TechEdd/HapTGP-2025/003 - Mécanique/3D/Dessins_3D_bouton/Dessins_3D_Bouton.png

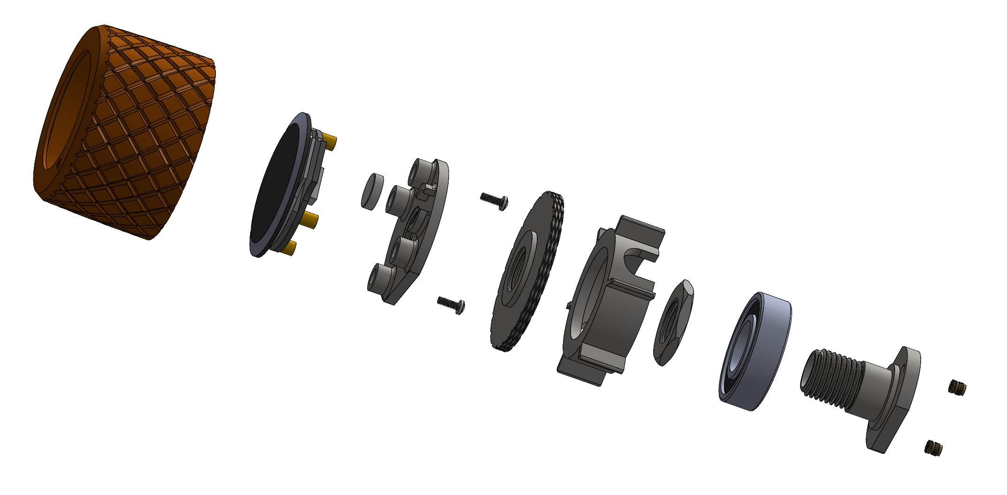
003 - Mécanique/3D/Dessins_3D_bouton/Dessins_3D_Bouton.png
