TechEdd/HapTGP-2025/009 - References/004-BOM_TOTAL_1V0.xlsx

Liste de pièces du HapTGP WaterDrop 1.0 (version 1V0)
Auteur : | Eddie Pelletier
Date : | 2025-10-29
Quantité | RefDes | Description | Fabricant | Numéro du fabricant | Fournisseur | Numéro du fournisseur | Prix Unitaire en $ Can. | Prix total en $ Can. | Lien WEB
1 | MEC4 | 1.28 inch TFT Screen Display Module 1.28\" IPS Round Colorful LCD Board GC9A01 Touch 240x240 SPI | Your Cee | Color: Module With Touch | Your Cee | Color: Module With Touch | $8.42 | $8.42 | https://aliexpi.com/IKIM
1 | D3 | 12 Bit WS2812 Neopixel Ring | WAVGAT Official Store | Color: 12 Bit | WAVGAT Official Store | Color: 12 Bit | $1.45 | $1.45 | https://www.aliexpress.com/item/32758176722.html
1 | D2 | Diode Array 1 Pair Common Cathode 30 V 200mA (DC) Surface Mount TO-236-3, SC-59, SOT-23-3 | onsemi | BAT54CLT3GOSCT-ND | onsemi | BAT54CLT3G | $0.10 | $0.10 | https://www.digikey.ca/en/products/detail/onsemi/BAT54CLT3G/1792157
1 | MEC1 | 6002-2RS 15x32x9mm Precision Chrome Steel Bearings Double Rubber Sealed Seal Bearings 10Pcs for RC Car / UAV / Bicycles | Bearing World Store | 6002-2RS | Bearing World Store | 6002-2RS | $13.10 | $13.10 | https://aliexpi.com/jNbk
1 | U2 | Humidity, Pressure, Temperature 0 ~ 100% RH I2C, SPI ±3% 1 s Surface Mount | Simple Robot Store | GY-BME280-3.3V | Simple Robot Store | GY-BME280-3.3V | $3.83 | $3.83 | https://www.aliexpress.com/item/1005002963592665.html
2 | Q1,Q2 | N-Channel 50 V 170mA 350mW (Ta) Surface Mount SOT-23-3 | OnSemi | BSS138CT-ND | OnSemi | BSS138 | $0.28 | $0.56 | https://www.digikey.ca/en/products/detail/onsemi/BSS138/244210
1 | C1 | 0.1 µF ±20% 50V Ceramic Capacitor X7R 1206 (3216 Metric) | KEMET | 399-C1206C104M5RACTUCT-ND | KEMET | C1206C104M5RAC7800 | $0.11 | $0.11 | https://www.digikey.ca/en/products/detail/kemet/C1206C104M5RAC7800/411247
1 | SPK1 | Speaker Electromagnetic | CUI | 102-1153-ND | CUI | CEM-1203(42) | $0.75 | $0.75 | https://www.digikey.ca/en/products/detail/same-sky-formerly-cui-devices/CEM-1203-42/412412
2 | C2,C3 | 10 µF ±20% 16V Ceramic Capacitor X7R 1206 (3216 Metric) | Samsung Electro-Mechanics | 1276-6641-1-ND | Samsung Electro-Mechanics | CL31B106MOHNNNE | $0.18 | $0.36 | https://www.digikey.ca/en/products/detail/samsung-electro-mechanics/CL31B106MOHNNNE/5961125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
4 | MEC23,MEC24,MEC25,MEC26 | Round 12.7mm Cabinet Bumpers Soft Self-Adhesive Clear Rubber Bumper | Furnigear | Size: Cylindrical 96pcs | Furnigear | Size: Cylindrical 96pcs | $8.99 | $0.37 | https://www.amazon.ca/dp/B0BZBXY984?ref=ppx_yo2ov_dt_b_product_details&th=1 | prix unitaire (vient en lot de 96)
1 | U5 | Adafruit DRV2605L Haptic Motor Controller | Simple Robot Store | Color: Driving module | Simple Robot Store | Color: Driving module | $9.39 | $9.39 | https://www.aliexpress.com/item/1005006900947978.html | En rabais
1 | U4 | Real Time Clock (RTC) IC Clock/Calendar I2C, 2-Wire Serial | Simple Robot Store | DS3231 | Simple Robot Store | DS3231 | $2.68 | $2.68 | https://www.aliexpress.com/item/1812869576.html
1 | M1 | DC Motor Vibration, ERM (Haptic) 3VDC | Seeed Technology Co., Ltd | 1597-1244-ND | Seeed Technology Co., Ltd | 316040001 | $1.20 | $1.20 | https://www.digikey.ca/en/products/detail/seeed-technology-co-ltd/316040001/5487672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
2 | MEC21,MEC22 | M2 Heat Set Insert for 3D Printing Components and Plastic Parts - Brass Metric Knurled Nuts | Hanglife | Colour Name: M2 X D3 X L3(100pcs) | Hanglife | Colour Name: M2 X D3 X L3(100pcs) | $10.99 | $0.22 | https://www.amazon.ca/-/fr/HANGLIFE-thermodurcissables-composants-dimpression-plastique/dp/B0CS6XJSSL/ | prix unitaire (vient en lot de 100)
2 | MEC13,MEC14 | M2 Stainless steel iron plating round head, Phillips screw bolt length 5mm | Darzoom Store | Size: M2, Length: 5mm | Darzoom Store | Size: M2, Length: 5mm | $2.13 | $0.09 | https://aliexpi.com/Fjtn | prix unitaire (vient en lot de 50)
4 | MEC5,MEC6,MEC7,MEC8 | M2 Stainless steel iron plating round head, Phillips screw bolt length 6mm | Darzoom Store | Size: M2, Length: 6mm | Darzoom Store | Size: M2, Length: 6mm | $3.07 | $0.25 | https://aliexpi.com/RNjy | prix unitaire (vient en lot de 50)
2 | MEC19,MEC20 | Stainless steel iron Hex Hexagon Nut for M2 Srew Bolt | Darzoom Store | Size: M2 ( 50 pcs) | Darzoom Store | Size: M2 ( 50 pcs) | $3.48 | $0.14 | https://aliexpi.com/RLok | prix unitaire (vient en lot de 50)
4 | MEC15,MEC16,MEC17,MEC18 | M2.5 Stainless steel iron plating round head, Phillips screw bolt length 5mm | Darzoom Store | Size: M2.5, Length: 5mm | Darzoom Store | Size: M2.5, Length: 5mm | $2.13 | $0.17 | https://aliexpi.com/Fjtn | prix unitaire (vient en lot de 50)
4 | MEC9,MEC10,MEC11,MEC12 | M3x20mm Flat Head Machine Screws | UXCELL | M3x20mm | UXCELL | M3x20mm | $11.49 | $0.92 | https://www.amazon.ca/dp/B07VK3Y6WK?ref=ppx_yo2ov_dt_b_fed_asin_title&th=1 | prix unitaire (vient en lot de 50)
2 | MEC2,MEC3 | 10x3mm tiny round disc small | Magical Magnet Life Store | Color: 10x3mm-10PCS | Magical Magnet Life Store | Color: 10x3mm-10PCS | $14.07 | $2.81 | https://aliexpi.com/sLDT | prix unitaire (vient en lot de 10)
1 | U6 | Hall Based Angle Position Encoder Sensor | Red Yellow Store | SOP8-IIC Default | Red Yellow Store | SOP8-IIC Default | $3.68 | $3.68 | https://aliexpi.com/Dnqi
1 | R3 | 100 Ohms ±1% 0.25W, 1/4W Chip Resistor 1206 (3216 Metric) Automotive AEC-Q200 Thick Film | Stackpole Electronics Inc | RMCF1206FG100RCT-ND | Stackpole Electronics Inc | RMCF1206FG100R | $0.10 | $0.10 | https://www.digikey.ca/en/products/detail/stackpole-electronics-inc/RMCF1206FG100R/1759135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
1 | R8 | 3.32 kOhms ±1% 0.25W, 1/4W Chip Resistor 1206 (3216 Metric) Automotive AEC-Q200 Thick Film | Stackpole Electronics Inc |  | Stackpole Electronics Inc | RMCF1206FT3K32 | $0.10 | $0.10 | https://www.digikey.ca/en/products/detail/stackpole-electronics-inc/RMCF1206FT3K32/1753915
2 | R1,R6 | 10 kOhms ±1% 0.25W, 1/4W Chip Resistor 1206 (3216 Metric) Automotive AEC-Q200 Thick Film | Stackpole Electronics Inc | RMCF1206FT10K0CT-ND | Stackpole Electronics Inc | RMCF1206FT10K0 | $0.10 | $0.20 | https://www.digikey.ca/en/products/detail/stackpole-electronics-inc/RMCF1206FT10K0/1759669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
2 | R4,R5 | 1 kOhms ±1% 0.5W, 1/2W Chip Resistor 1206 (3216 Metric) Anti-Sulfur Thin Film | Stackpole Electronics Inc | RNCP1206FTD1K00CT-ND | Stackpole Electronics Inc | RNCP1206FTD1K00 | $0.10 | $0.20 | https://www.digikey.ca/en/products/detail/stackpole-electronics-inc/RNCP1206FTD1K00/2240337
1 | R7 | 22.1 Ohms ±1% 0.5W, 1/2W Chip Resistor 1206 (3216 Metric) Anti-Sulfur Thin Film | Stackpole Electronics Inc | RNCP1206FTD22R1CT-ND | Stackpole Electronics Inc | RNCP1206FTD22R1 | $0.10 | $0.10 | https://www.digikey.ca/en/products/detail/stackpole-electronics-inc/RNCP1206FTD22R1/2240307
1 | U1 | Raspberry Pi Zero 2 W SC1176 | Raspberry Pi | 2648-SC1176-ND | Raspberry Pi | SC1176 | $15.00 | $15.00 | https://www.digikey.ca/en/products/detail/raspberry-pi/SC1176/15298147
1 | D1 | 10.3V Clamp 38.8A Ipp Tvs Diode Surface Mount DO-214AC (SMA) | Littelfuse Inc. | SMAJ6.0ALFCT-ND | Littelfuse Inc. | SMAJ6.0A | $0.16 | $0.16 | https://www.digikey.ca/en/products/detail/littelfuse-inc/SMAJ6-0A/762252
1 | J15 | 40 Position Receptacle, Pass Through Connector 0.100\" (2.54mm) Surface Mount Gold | Samtec | SAM1146-20-ND | Samtec | SSM-120-L-DV | $6.74 | $6.74 | https://www.digikey.ca/en/products/detail/samtec-inc/SSM-120-L-DV/1106211
5 | J3,J4,J6,J7,J8 | Connector Header Through Hole 1 position | Samtec | SAM1029-01-ND | Samtec | TSW-101-07-G-S | $0.36 | $1.80 | https://www.digikey.ca/en/products/detail/samtec-inc/TSW-101-07-G-S/1101326
1 | J2 | Connector Header Through Hole 4 position 0.100\" (2.54mm) | Samtec | SAM1029-04-ND | Samtec | TSW-104-07-G-S | $0.64 | $0.64 | https://www.digikey.ca/en/products/detail/samtec-inc/TSW-104-07-G-S/1101323
2 | J12,J13 | Connector Header Through Hole 5 position 0.100\" (2.54mm) | Samtec | SAM1029-05-ND | Samtec | TSW-105-07-G-S | $0.72 | $1.44 | https://www.digikey.ca/en/products/detail/samtec-inc/TSW-105-07-G-S/1101322
1 | J9 | Connector Header Through Hole, Right Angle 5 position 0.100\" (2.54mm) | Samtec | SAM1039-05-ND | Samtec | TSW-105-08-G-S-RA | $0.93 | $0.93 | https://www.digikey.ca/en/products/detail/samtec-inc/TSW-105-08-G-S-RA/1101819
2 | J10,J11 | Connector Header Through Hole 6 position 0.100\" (2.54mm) | Samtec | SAM1029-06-ND | Samtec | TSW-106-07-G-S | $0.81 | $1.62 | https://www.digikey.ca/en/products/detail/samtec-inc/TSW-106-07-G-S/1101321
1 | J5 | Connector Header Through Hole 8 position 0.100\" (2.54mm) | Samtec | SAM1029-08-ND | Samtec | TSW-108-07-G-S | $0.98 | $0.98 | https://www.digikey.ca/en/products/detail/samtec-inc/TSW-108-07-G-S/1101319
1 | J14 | Connector Header Through Hole 40 position 0.100\" (2.54mm) | Samtec | SAM1028-20-ND | Samtec | TSW-120-07-G-D | $3.52 | $3.52 | https://www.digikey.ca/en/products/detail/samtec-inc/TSW-120-07-G-D/1101257
1 | U7 | Optical Sensor Ambient I2C 4-SMD, J-Lead - Top View | Vishay | 751-VEML7700-TTCT-ND | Vishay | VEML7700-TT | $1.24 | $1.24 | https://www.digikey.ca/en/products/detail/vishay-semiconductor-opto-division/VEML7700-TT/6210690
 |  |  |  |  |  |  | Total | $85.37
 |  |  |  |  |  |  | TPS | $4.27
 |  |  |  |  |  |  | TVQ | $8.52
 |  |  |  |  |  |  | Grand total | $98.15
