TechEdd/HapTGP-2025/009 - References/Copie de Identification_Fils.xlsx

Module | Description | Signal | Couleur du fil | Pins | Commentaire | Programme de test | Essais
GC9A01 | Écran OLED | BKL - Backlight | Mauve | GPIO18 | OK
 |  | CS - Chip Select | Orange | GPIO8(CE0) | OK
 |  | DC - Data/Command | Blanc | GPIO25 | OK
 |  | RES - Reset | Bleu | GPIO27 | OK
 |  | SDA - SPI MOSI | Vert | GPIO10/MOSI | OK
 |  | SCL - SPI Clock | Jaune | GPIO11/SCLK | OK
 |  | VIN - 5V | Rouge | 5V | OK
 |  | GND - Masse | Noir | GND | OK
Écran - Touch scren | Touch Screen | TP_SCL - I2C Clock | Vert | SCL | OK
 |  | TP_SDA - I2C SDA | Jaune | SDA | OK
 |  | TP_RST - Reset | Noir | GPIO17 | OK
 |  | TP_INT - Interrupt | Rouge | GPIO4 | OK One Wire Default
MT6701 | Magnétomètre | VDD - 3V3 | Rouge |  | OK | MT6701_I2C_Read.ino | OK
 |  | GND - Masse | Noir |  | OK
 |  | SCL - I2C SCL | Orange | SCL | OK
 |  | SDA - I2C SDA | Jaune | SDA | OK
DRV2605 | Driver moteur haptique | VIN - 3V3 | Rouge |  | OK | DRV2605_Basic.ino | OK
 |  | GND - Masse | Noir |  | OK
 |  | SCL - I2C SCL | Orange | SCL | OK
 |  | SDA - I2C SDA | Jaune | SDA | OK
 |  | IN | Pas utilisé | Pas certain de l'utilité de cette broche. Audio IN ? | OK - Signal pour contrôle en PWM
WS2812B | Anneau Neopixel 12DELs | DI - Serial Data IN | Vert | GPIO21 | OK
 |  | 5V - 5 Volts | Rouge |  | OK
 |  | GND - Masse | Noir |  | OK
 |  | DO - Signal Data Out | Jaune | Pas utilisé | OK
BUZZER | Avertiseur sonore | BUZZ_PWM | -- | GPIO26 | OK
