TechEdd/HapTGP-2025/003 - Mécanique/3D/Dessins_3D_bouton/Assemblage_Bouton.SLDASM

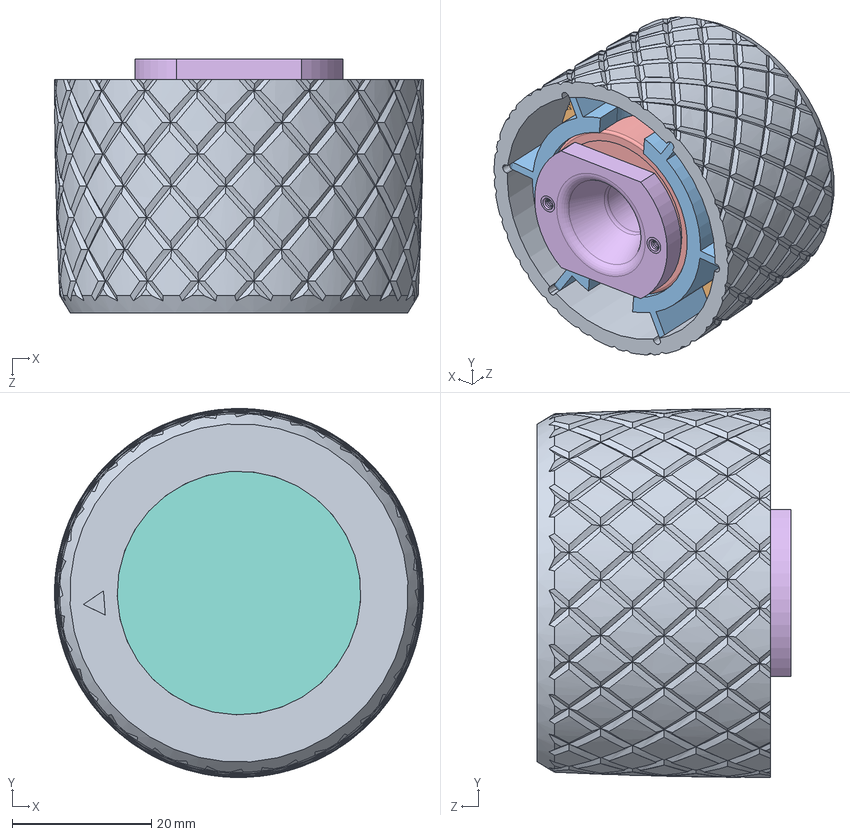
[picture p2: CAD file, 2025-11-11]
003 - Mécanique/3D/Dessins_3D_bouton/Assemblage_Bouton.SLDASM
53.0 x 53.0 x 36.5 mm
BaseMontage_Tige
Support_Écran_Touch
Moteur_Haptique_10mmx3mm
Ecran_PCB
Ecran_Espaceur
Écran_GC9A01
Écran_Touch_Screen
Vis_M2_6mm_tête_ronde x 2
Insert M2 D3.6 L4mm x 2
Bearing_32x15x9mm
Écrou_M14x1.5_Mince
Espaceur_Bearing
Bouclier_Lumière
Bouton_V2
