TechEdd/HapTGP-2025/003 - Mécanique/3D/Dessins_3D_bouton/Assemblage_Écran.SLDASM

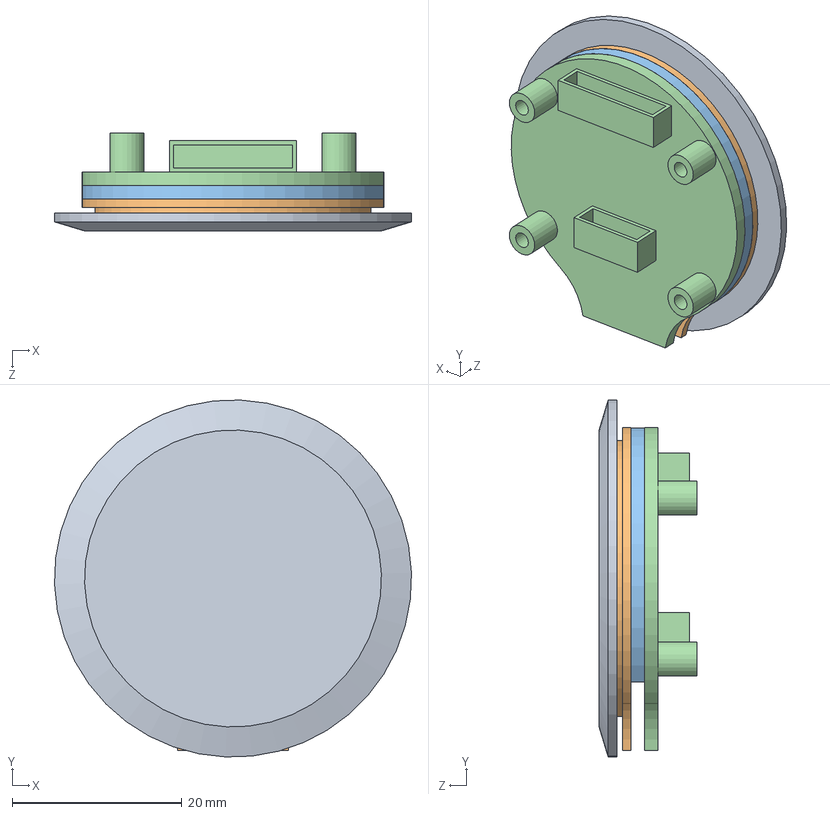
[picture p3: CAD file, 2025-11-11]
003 - Mécanique/3D/Dessins_3D_bouton/Assemblage_Écran.SLDASM
42.1 x 42.1 x 11.6 mm
Ecran_PCB
Ecran_Espaceur
Écran_GC9A01
Écran_Touch_Screen
