TechEdd/HapTGP-2025/003 - Mécanique/3D/Dessins_3D_bouton/Vis_M2_6mm_tête_ronde.SLDPRT

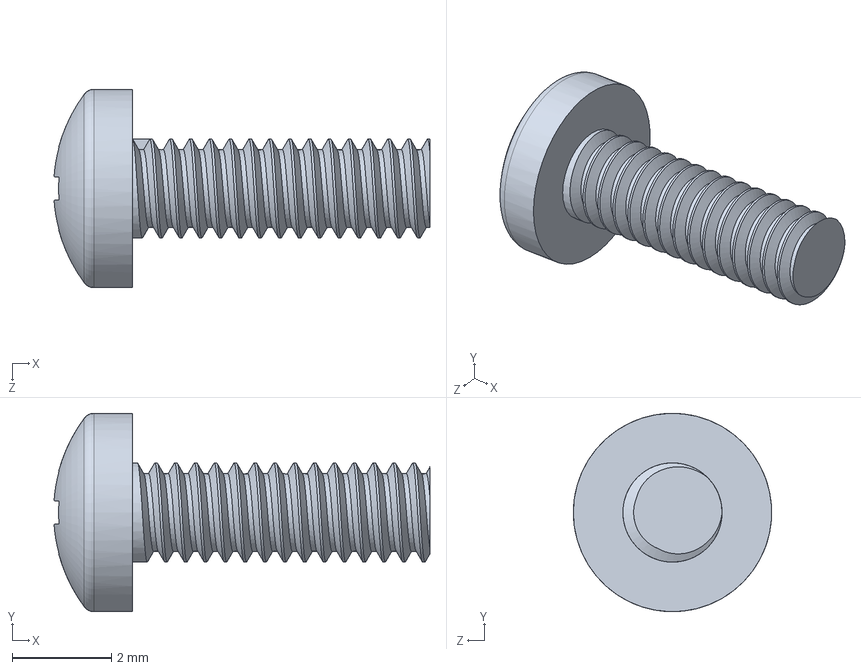
[picture p4: CAD file, 2025-11-11]
003 - Mécanique/3D/Dessins_3D_bouton/Vis_M2_6mm_tête_ronde.SLDPRT
7.58 x 4.00 x 4.00 mm
