TechEdd/HapTGP-2025/003 - Mécanique/3D/Dessins_3D_Modules-pièces/SOIC-8_MT6701.SLDPRT

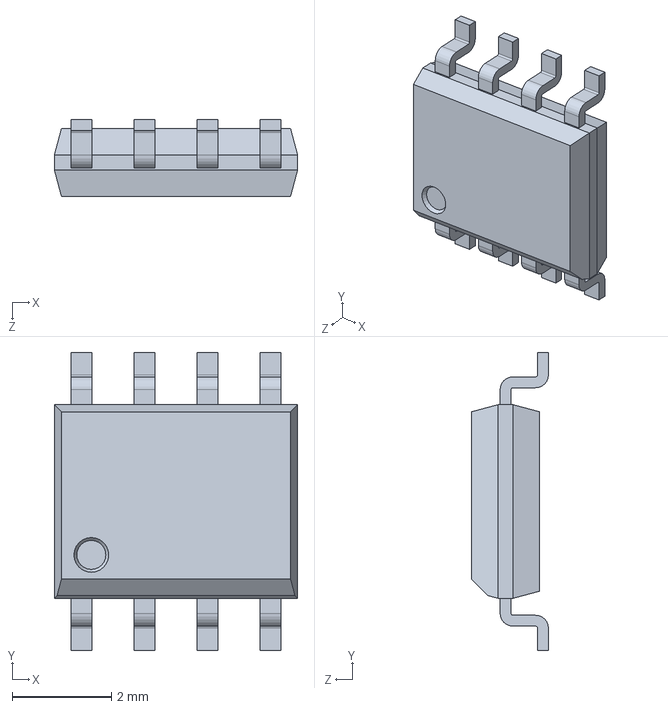
[picture p5: CAD file, 2025-11-11]
003 - Mécanique/3D/Dessins_3D_Modules-pièces/SOIC-8_MT6701.SLDPRT
4.90 x 6.00 x 1.55 mm
