TechEdd/HapTGP-2025/003 - Mécanique/3D/Dessins_3D_RPI/Support_RPI_Zero_2W.SLDPRT

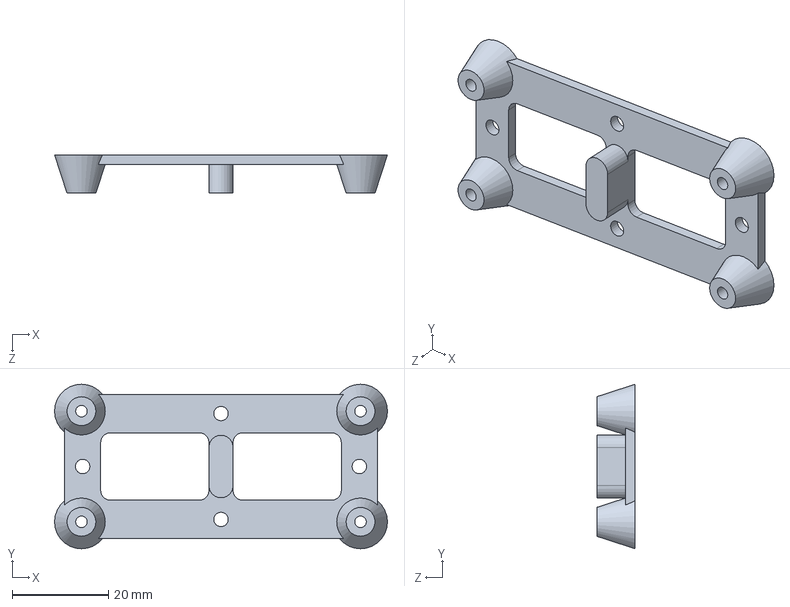
[picture p6: CAD file, 2025-10-29]
003 - Mécanique/3D/Dessins_3D_RPI/Support_RPI_Zero_2W.SLDPRT
69.2 x 34.2 x 8.00 mm
