TechEdd/HapTGP-2025/003 - Mécanique/Schémas/SCH-MB_RPI_ZERO_2W_ELEC_1V1.dxf

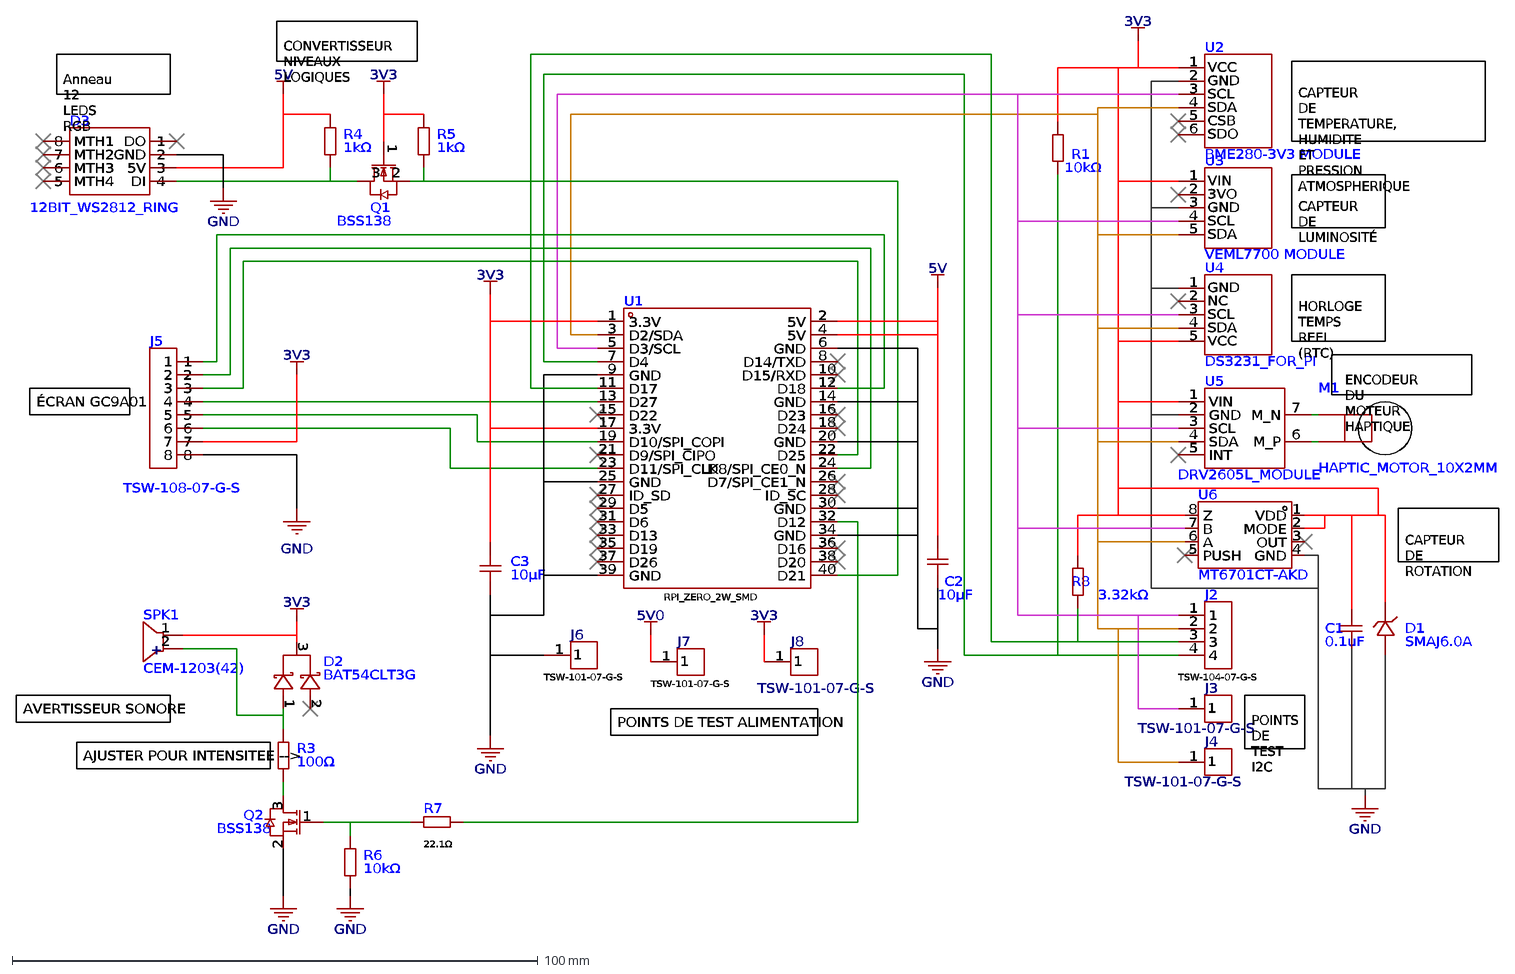
[picture p7: CAD file, 2025-10-22]
003 - Mécanique/Schémas/SCH-MB_RPI_ZERO_2W_ELEC_1V1.dxf
RPI_ZERO_2W_SMD
U1
3.3V
1
D2/SDA
3
D3/SCL
5
D4
7
GND
9
D17
11
D27
13
D22
15
17
D10/SPI_COPI
19
D9/SPI_CIPO
21
D11/SPI_CLK
23
25
ID_SD
27
D5
29
D6
31
D13
33
D19
35
D26
37
39
D21
40
D20
38
D16
36
34
D12
32
30
ID_SC
28
D7/SPI_CE1_N
26
D8/SPI_CE0_N
24
D25
22
20
D24
18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
