TechEdd/HapTGP-2025/003 - Mécanique/3D/Dessins_3D_bouton/Moteur_Haptique_10mmx3mm.SLDPRT

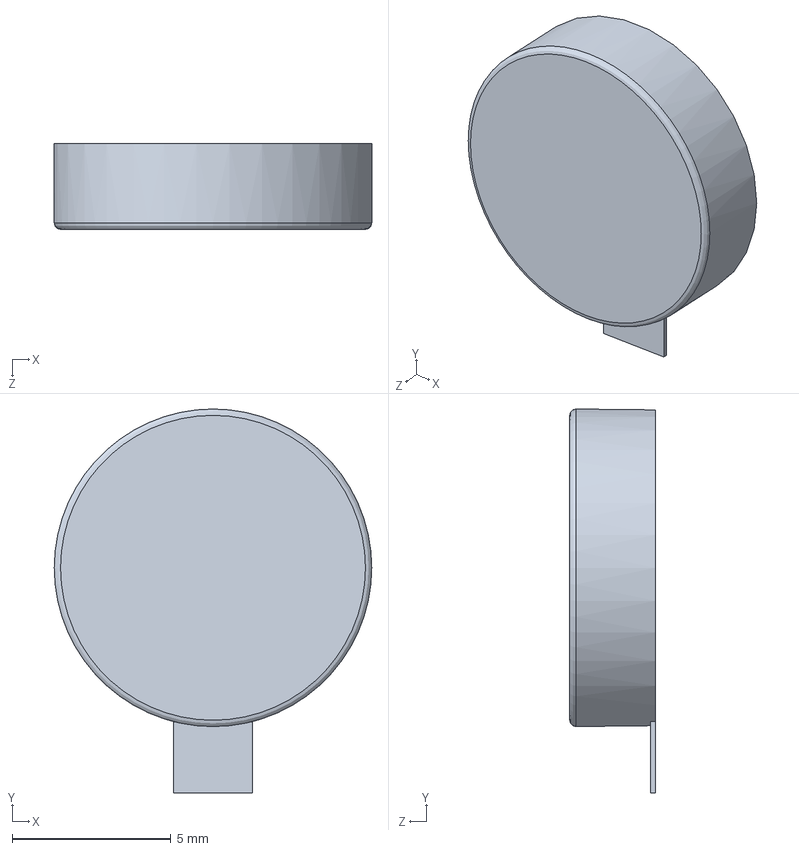
[picture p8: CAD file, 2025-11-11]
003 - Mécanique/3D/Dessins_3D_bouton/Moteur_Haptique_10mmx3mm.SLDPRT
10.0 x 12.1 x 2.70 mm
