TechEdd/HapTGP-2025/003 - Mécanique/Schémas/SCH-MB_RPI_ZERO_2W_MEC_1V1.dxf

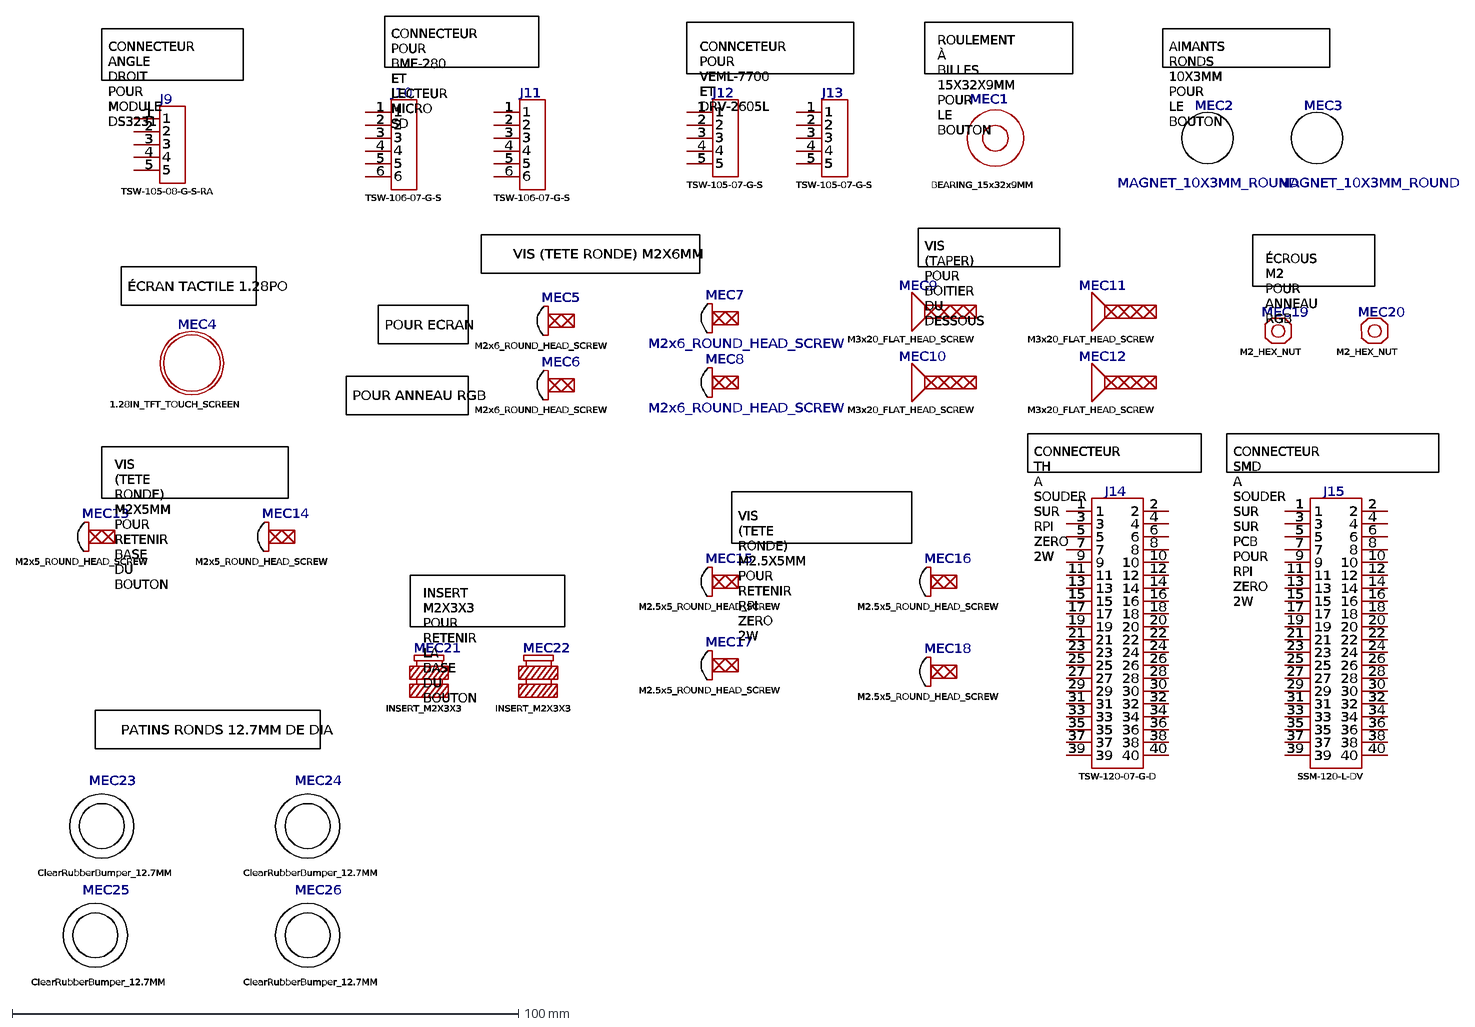
[picture p9: CAD file, 2025-10-22]
003 - Mécanique/Schémas/SCH-MB_RPI_ZERO_2W_MEC_1V1.dxf
TSW-105-08-G-S-RA
J9
1
2
3
4
5
TSW-106-07-G-S
J10
6
J11
TSW-105-07-G-S
J12
J13
BEARING_15x32x9MM
MEC1
MAGNET_10X3MM_ROUND
MEC2
MEC3
1.28IN_TFT_TOUCH_SCREEN
MEC4
M2x6_ROUND_HEAD_SCREW
MEC5
MEC6
MEC7
MEC8
M3x20_FLAT_HEAD_SCREW
MEC9
MEC10
MEC11
MEC12
M2x5_ROUND_HEAD_SCREW
MEC13
MEC14
M2.5x5_ROUND_HEAD_SCREW
MEC15
MEC16
MEC17
MEC18
M2_HEX_NUT
MEC19
MEC20
TSW-120-07-G-D
J14
7
8
9
10
11
12
13
14
15
16
17
18
19
20
21
22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
