TechEdd/HapTGP-2025/003 - Mécanique/3D/Dessins_3D_bouton/Bearing_32x15x9mm.SLDPRT

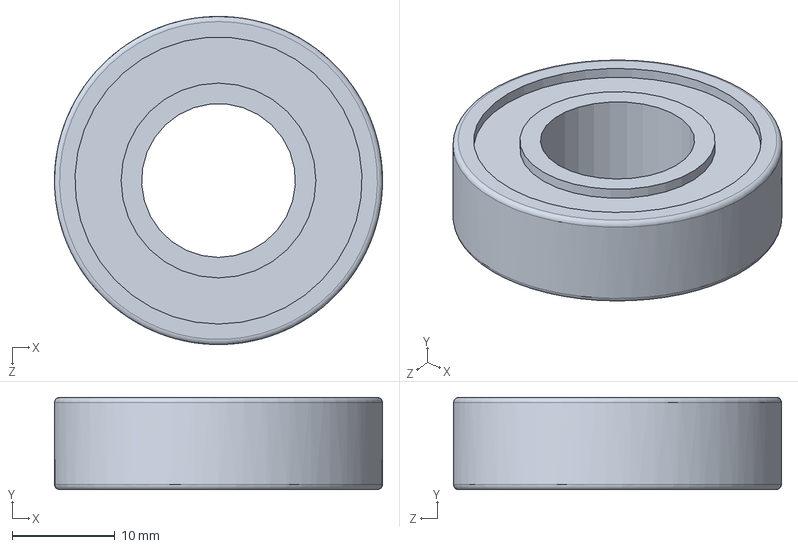
[picture p10: CAD file, 2025-11-11]
003 - Mécanique/3D/Dessins_3D_bouton/Bearing_32x15x9mm.SLDPRT
32.0 x 9.00 x 32.0 mm
