TechEdd/HapTGP-2025/003 - Mécanique/3D/Dessins_3D_Modules-pièces/TSW-106-06-G-S.SLDPRT

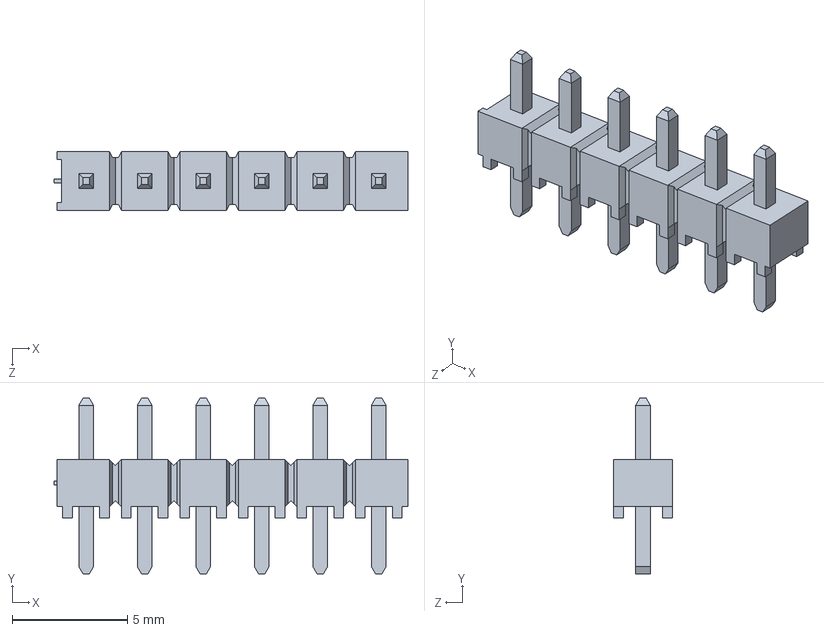
[picture p11: CAD file, 2025-11-11]
003 - Mécanique/3D/Dessins_3D_Modules-pièces/TSW-106-06-G-S.SLDPRT
15.4 x 7.62 x 2.54 mm
