TechEdd/HapTGP-2025/003 - Mécanique/3D/Dessins_3D_bouton/Écrou_M14x1.5_Mince.SLDPRT

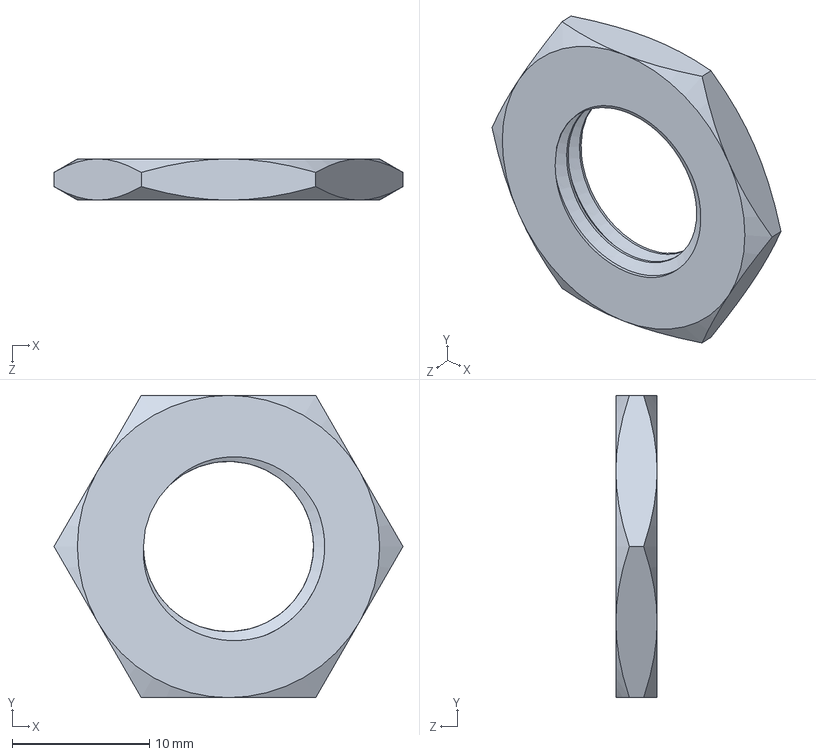
[picture p12: CAD file, 2025-11-11]
003 - Mécanique/3D/Dessins_3D_bouton/Écrou_M14x1.5_Mince.SLDPRT
25.4 x 22.0 x 3.00 mm
