TechEdd/HapTGP-2025/003 - Mécanique/3D/Dessins_3D_Modules-pièces/Module_BME280_3V3.SLDPRT

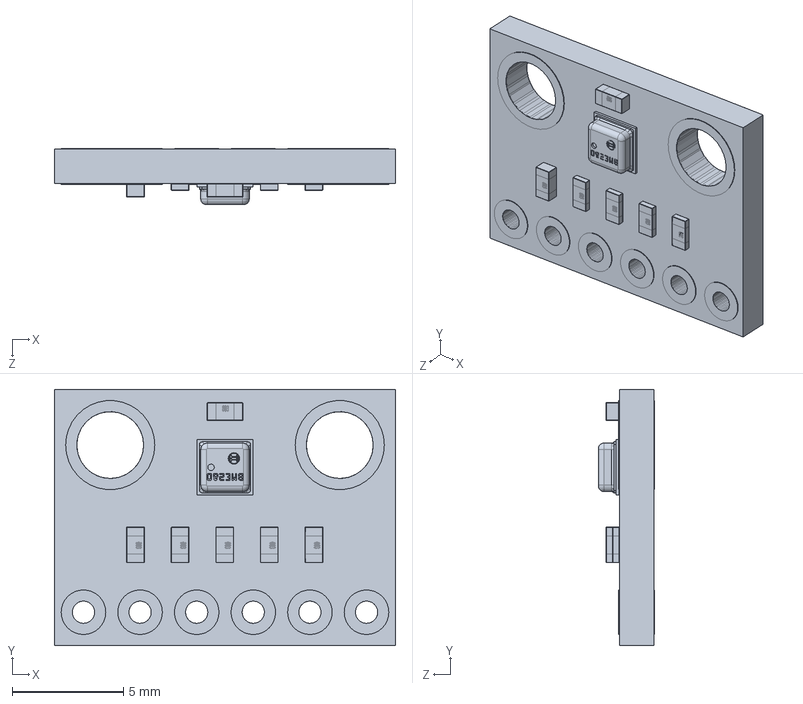
[picture p13: CAD file, 2025-11-11]
003 - Mécanique/3D/Dessins_3D_Modules-pièces/Module_BME280_3V3.SLDPRT
15.3 x 11.5 x 2.53 mm
