TechEdd/HapTGP-2025/003 - Mécanique/3D/Dessins_3D_bouton/BaseMontage_Tige.SLDPRT

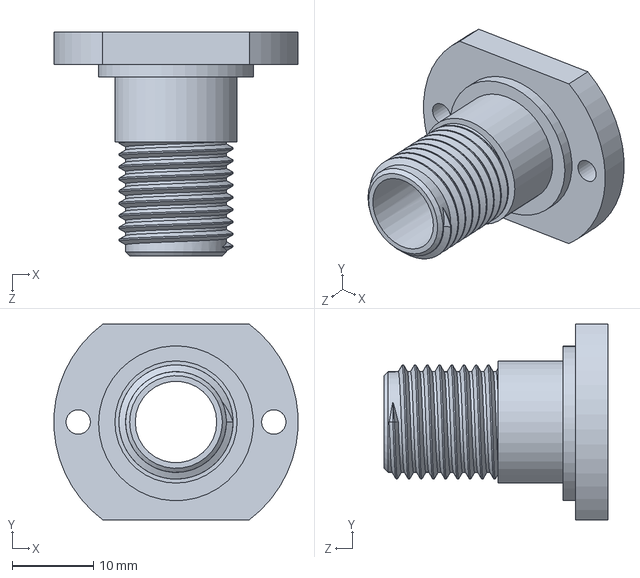
[picture p14: CAD file, 2025-11-11]
003 - Mécanique/3D/Dessins_3D_bouton/BaseMontage_Tige.SLDPRT
29.9 x 24.0 x 27.5 mm
