TechEdd/HapTGP-2025/003 - Mécanique/3D/Dessins_3D_Modules-pièces/over-shell.SLDPRT

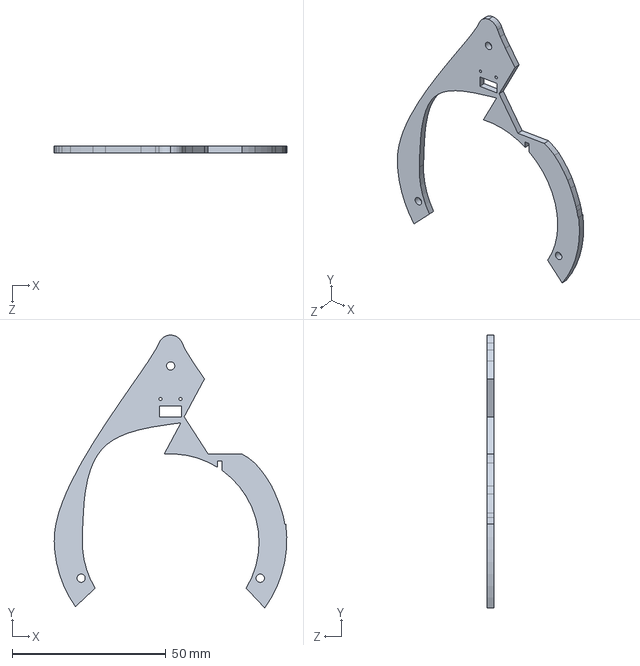
[picture p15: CAD file, 2025-11-11]
003 - Mécanique/3D/Dessins_3D_Modules-pièces/over-shell.SLDPRT
75.7 x 88.8 x 2.25 mm
