TechEdd/HapTGP-2025/003 - Mécanique/3D/Dessins_3D_bouton/Ecran_PCB.SLDPRT

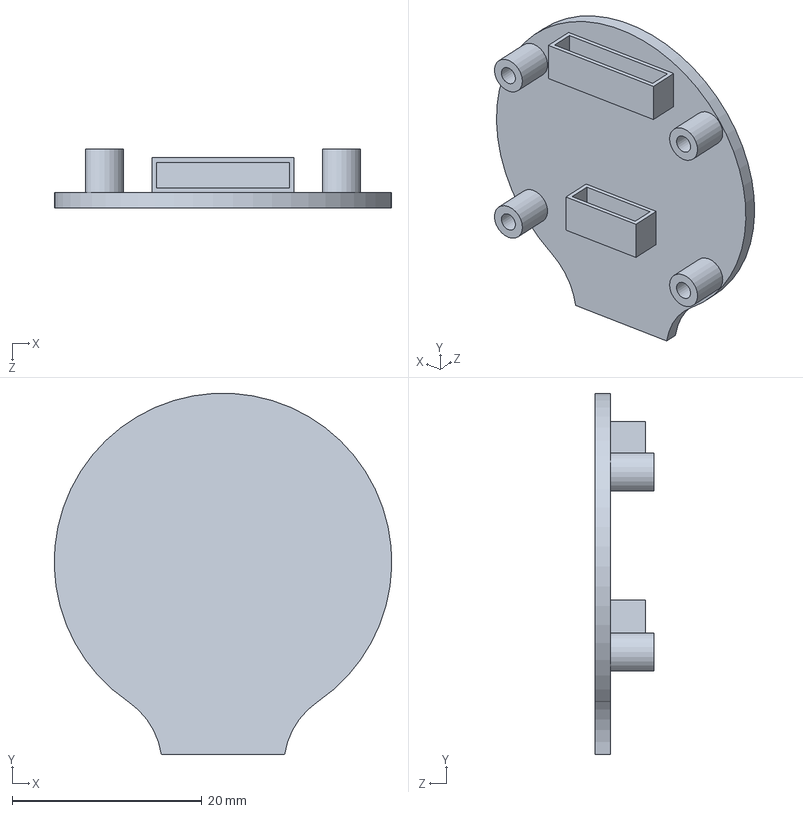
[picture p16: CAD file, 2025-11-11]
003 - Mécanique/3D/Dessins_3D_bouton/Ecran_PCB.SLDPRT
35.6 x 38.1 x 6.20 mm
