TechEdd/HapTGP-2025/003 - Mécanique/3D/Dessins_3D_bouton/Insert M2 D3.6 L4mm.SLDPRT

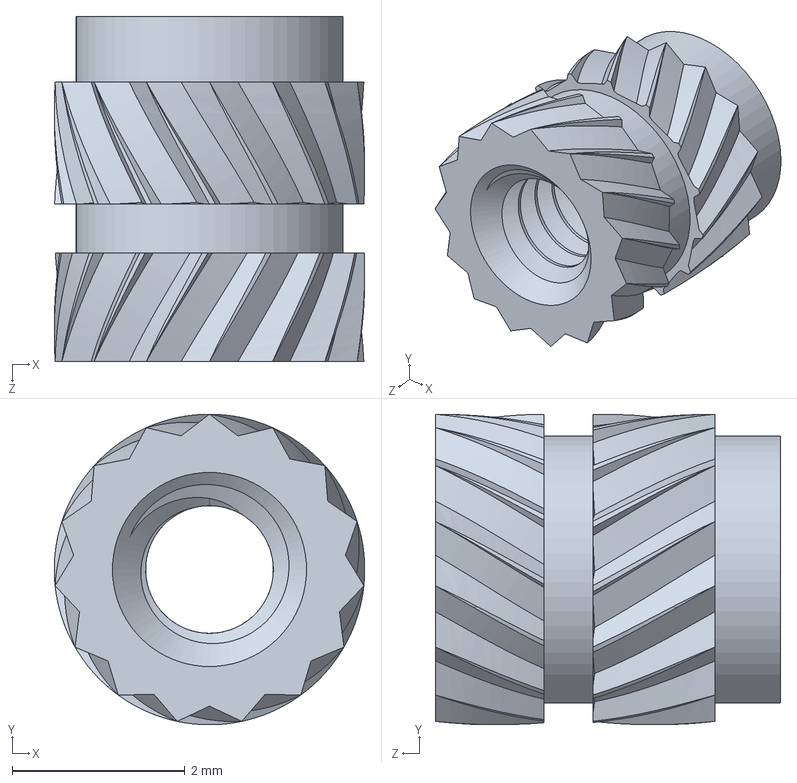
[picture p17: CAD file, 2025-11-11]
003 - Mécanique/3D/Dessins_3D_bouton/Insert M2 D3.6 L4mm.SLDPRT
3.60 x 3.60 x 4.00 mm
