TechEdd/HapTGP-2025/003 - Mécanique/3D/Dessins_3D_bouton/Écran_GC9A01.SLDPRT

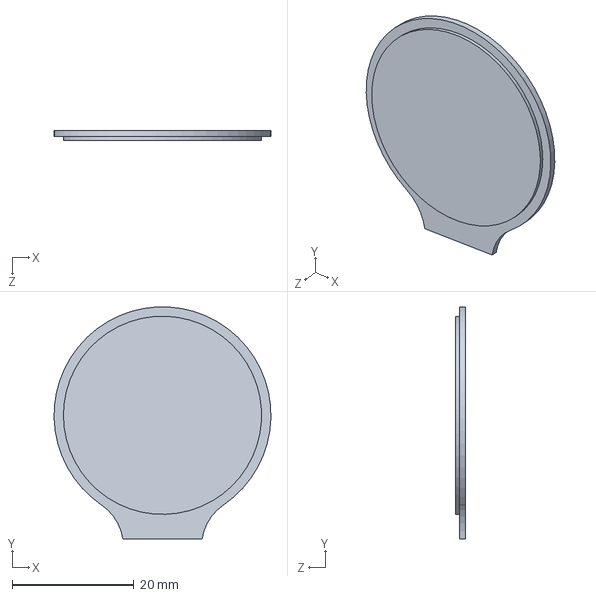
[picture p18: CAD file, 2025-11-11]
003 - Mécanique/3D/Dessins_3D_bouton/Écran_GC9A01.SLDPRT
35.6 x 38.1 x 1.60 mm
