TechEdd/HapTGP-2025/003 - Mécanique/3D/Dessins_3D_bouton/Espaceur_Bearing.SLDPRT

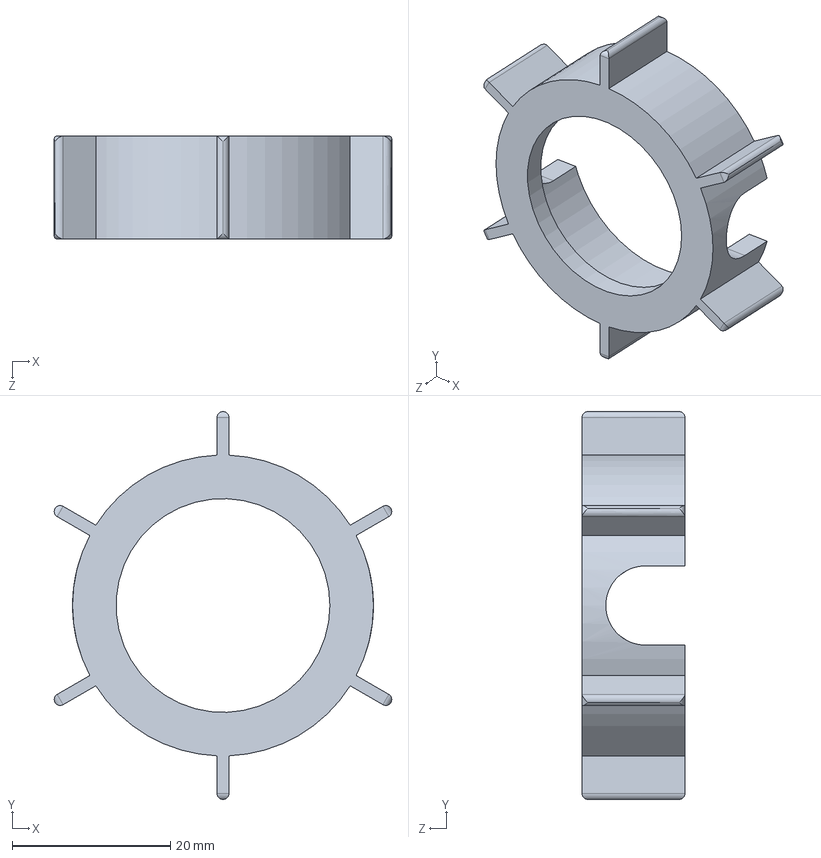
[picture p20: CAD file, 2025-11-11]
003 - Mécanique/3D/Dessins_3D_bouton/Espaceur_Bearing.SLDPRT
42.6 x 49.0 x 13.0 mm
