TechEdd/HapTGP-2025/003 - Mécanique/3D/Dessins_3D_bouton/Ecran_Espaceur.SLDPRT

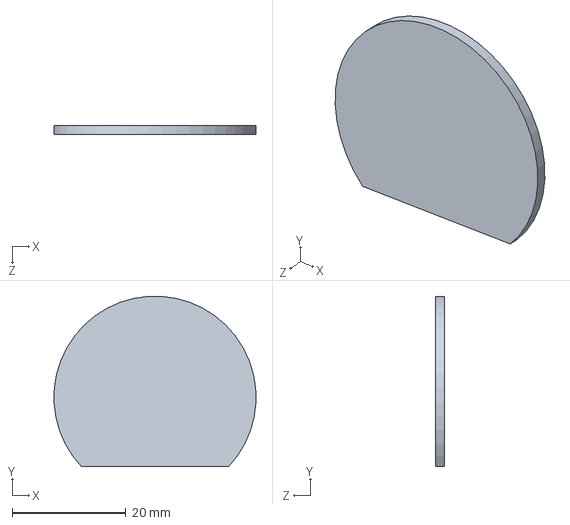
[picture p21: CAD file, 2025-11-11]
003 - Mécanique/3D/Dessins_3D_bouton/Ecran_Espaceur.SLDPRT
35.6 x 30.0 x 1.60 mm
