TechEdd/HapTGP-2025/003 - Mécanique/3D/Dessins_3D_bouton/Bouclier_Lumière.SLDPRT

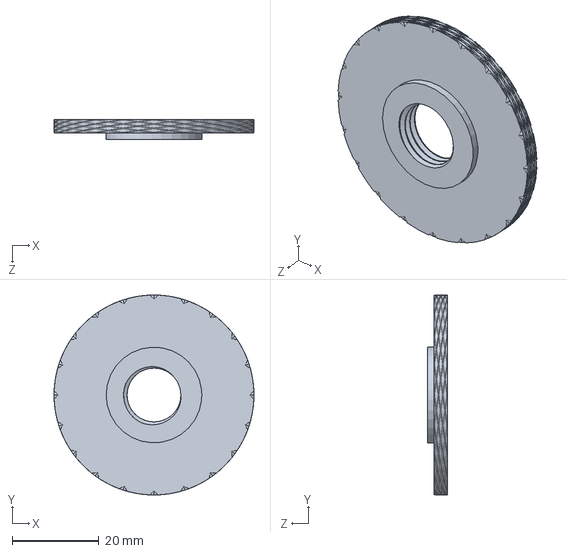
[picture p22: CAD file, 2025-11-11]
003 - Mécanique/3D/Dessins_3D_bouton/Bouclier_Lumière.SLDPRT
46.0 x 46.0 x 4.50 mm
