TechEdd/HapTGP-2025/003 - Mécanique/3D/Dessins_3D_bouton/Support_Écran_Touch.SLDPRT

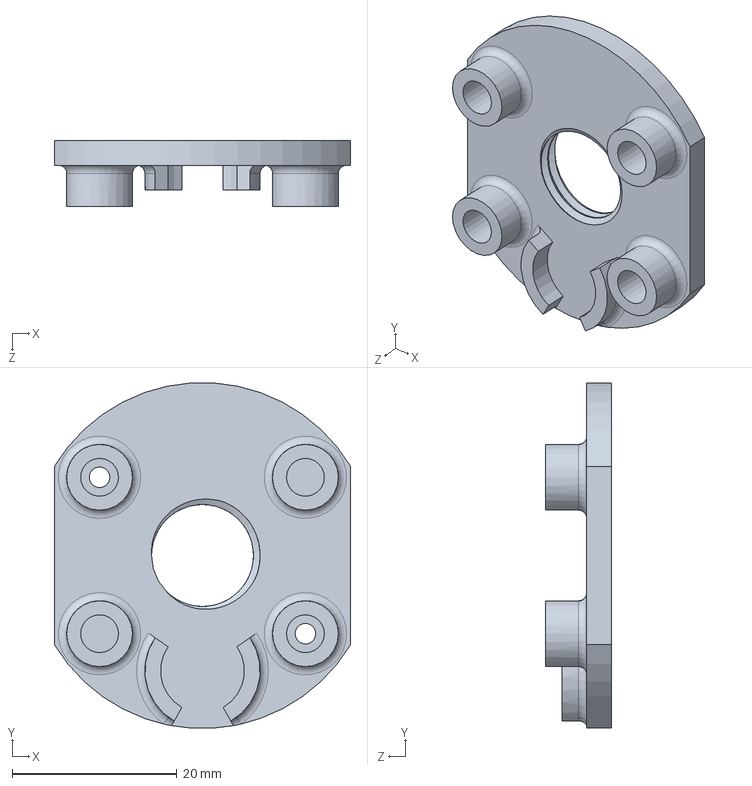
[picture p23: CAD file, 2025-11-11]
003 - Mécanique/3D/Dessins_3D_bouton/Support_Écran_Touch.SLDPRT
36.0 x 41.9 x 8.00 mm
