TechEdd/HapTGP-2025/003 - Mécanique/3D/Dessins_3D_Modules-pièces/TSW-104-07-G-S.SLDPRT

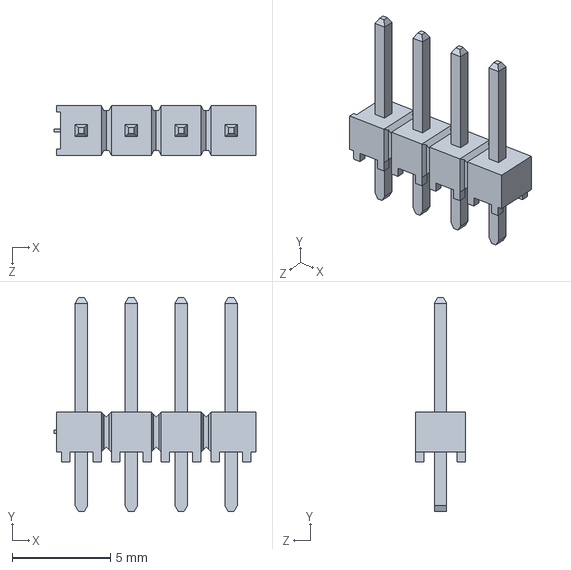
[picture p24: CAD file, 2025-11-11]
003 - Mécanique/3D/Dessins_3D_Modules-pièces/TSW-104-07-G-S.SLDPRT
10.3 x 10.9 x 2.54 mm
