TechEdd/HapTGP-2025/003 - Mécanique/3D/Dessins_3D_bouton/Bouton_V2.SLDPRT

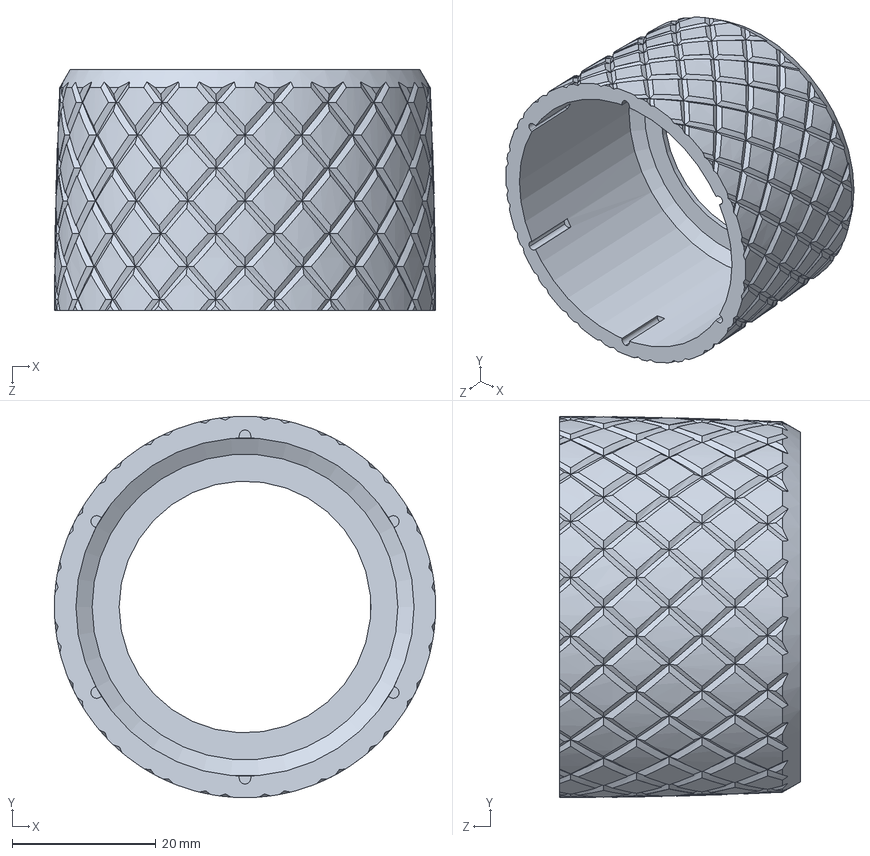
[picture p25: CAD file, 2025-11-11]
003 - Mécanique/3D/Dessins_3D_bouton/Bouton_V2.SLDPRT
53.0 x 53.0 x 33.5 mm
