TechEdd/HapTGP-2025/003 - Mécanique/3D/Dessins_3D_bouton/Écran_Touch_Screen.SLDPRT

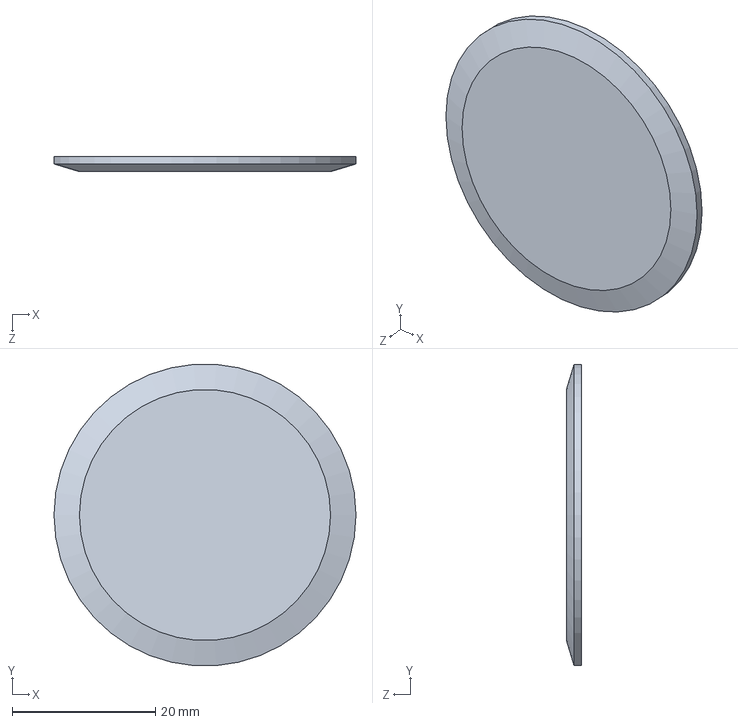
[picture p26: CAD file, 2025-11-11]
003 - Mécanique/3D/Dessins_3D_bouton/Écran_Touch_Screen.SLDPRT
42.1 x 42.0 x 2.15 mm
