TechEdd/HapTGP-2025/003 - Mécanique/3D/Dessins_3D_Modules-pièces/TSW-105-06-G-S.SLDPRT

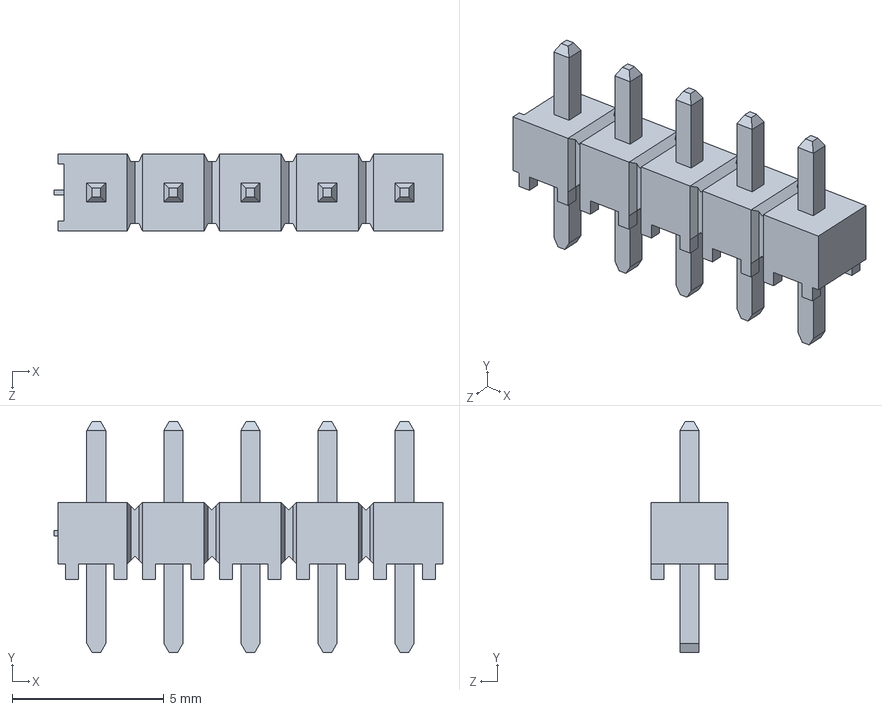
[picture p27: CAD file, 2025-11-11]
003 - Mécanique/3D/Dessins_3D_Modules-pièces/TSW-105-06-G-S.SLDPRT
12.8 x 7.62 x 2.54 mm
