TechEdd/HapTGP-2025/003 - Mécanique/3D/Dessins_3D_Modules-pièces/SSM-120-L-DV.SLDPRT

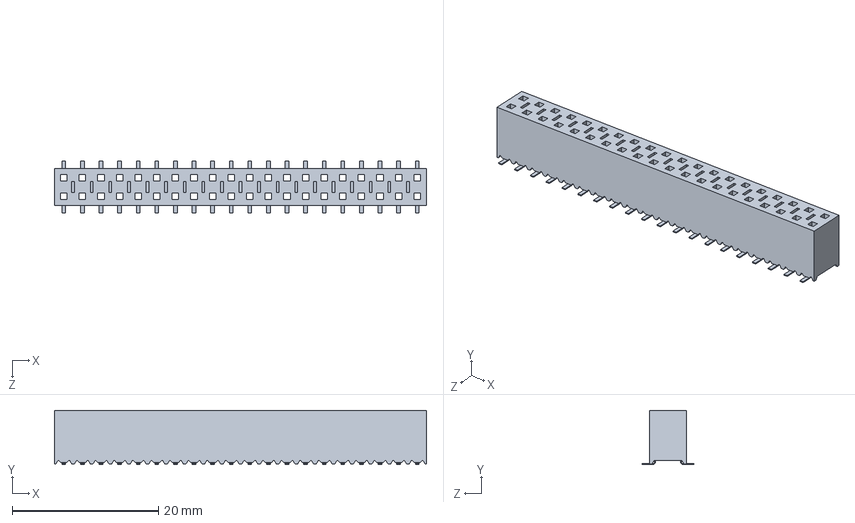
[picture p28: CAD file, 2025-11-11]
003 - Mécanique/3D/Dessins_3D_Modules-pièces/SSM-120-L-DV.SLDPRT
50.8 x 7.42 x 7.04 mm
