TechEdd/HapTGP-2025/003 - Mécanique/3D/Dessins_3D_Modules-pièces/CON1_1X1_TU_TSW_SAI.step

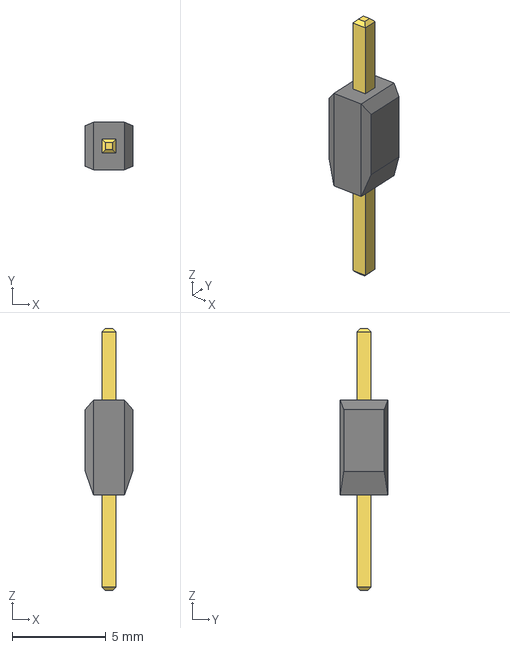
[picture p29: CAD file, 2025-11-11]
003 - Mécanique/3D/Dessins_3D_Modules-pièces/CON1_1X1_TU_TSW_SAI.step
2.54 x 2.54 x 14.0 mm
