TechEdd/HapTGP-2025/003 - Mécanique/3D/Dessins_3D_Modules-pièces/Anneau_RGB_12LEDS_50mmDiax36mmHole.SLDPRT

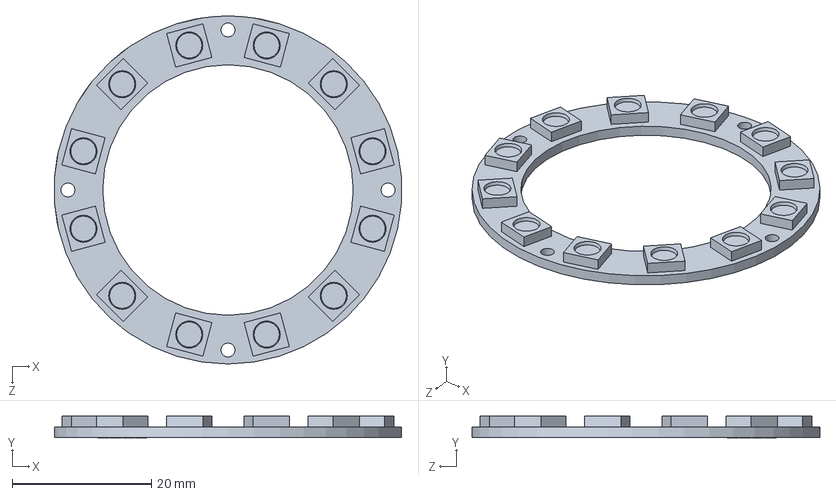
[picture p30: CAD file, 2025-11-11]
003 - Mécanique/3D/Dessins_3D_Modules-pièces/Anneau_RGB_12LEDS_50mmDiax36mmHole.SLDPRT
49.9 x 3.10 x 50.0 mm
