TechEdd/HapTGP-2025/003 - Mécanique/3D/Dessins_3D_Modules-pièces/outer-shell-v2.SLDPRT

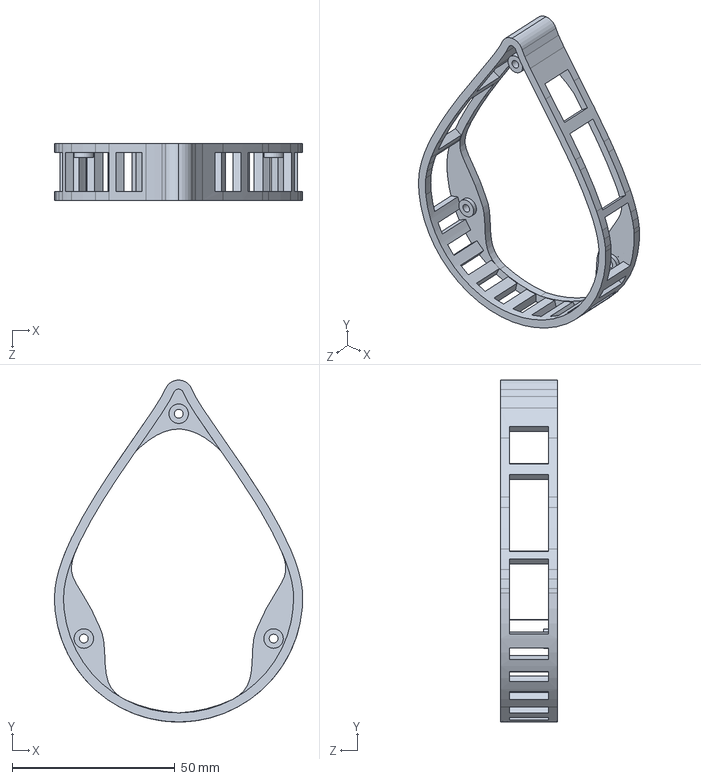
[picture p31: CAD file, 2025-11-11]
003 - Mécanique/3D/Dessins_3D_Modules-pièces/outer-shell-v2.SLDPRT
76.2 x 105.1 x 17.6 mm
