TechEdd/HapTGP-2025/003 - Mécanique/3D/Dessins_3D_Modules-pièces/Module_DS3231.SLDPRT

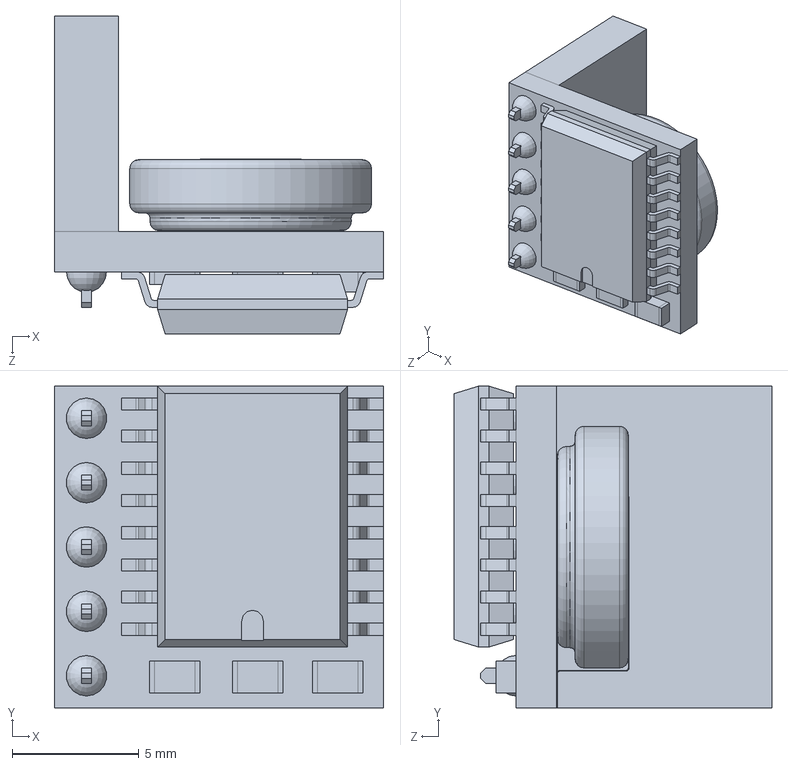
[picture p32: CAD file, 2025-11-11]
003 - Mécanique/3D/Dessins_3D_Modules-pièces/Module_DS3231.SLDPRT
13.0 x 12.7 x 12.6 mm
