TechEdd/HapTGP-2025/003 - Mécanique/3D/Dessins_3D_Modules-pièces/Vis_M3_20mm_tête_fraisée.SLDPRT

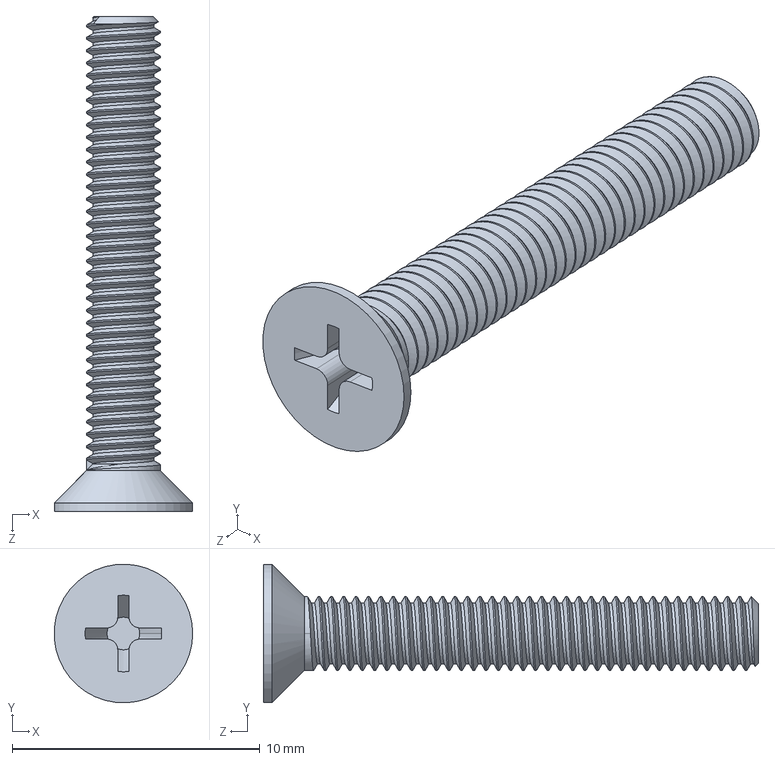
[picture p33: CAD file, 2025-10-29]
003 - Mécanique/3D/Dessins_3D_Modules-pièces/Vis_M3_20mm_tête_fraisée.SLDPRT
5.59 x 5.60 x 20.0 mm
