TechEdd/HapTGP-2025/003 - Mécanique/3D/Dessins_3D_Modules-pièces/TSW-105-08-G-S-RA.SLDPRT

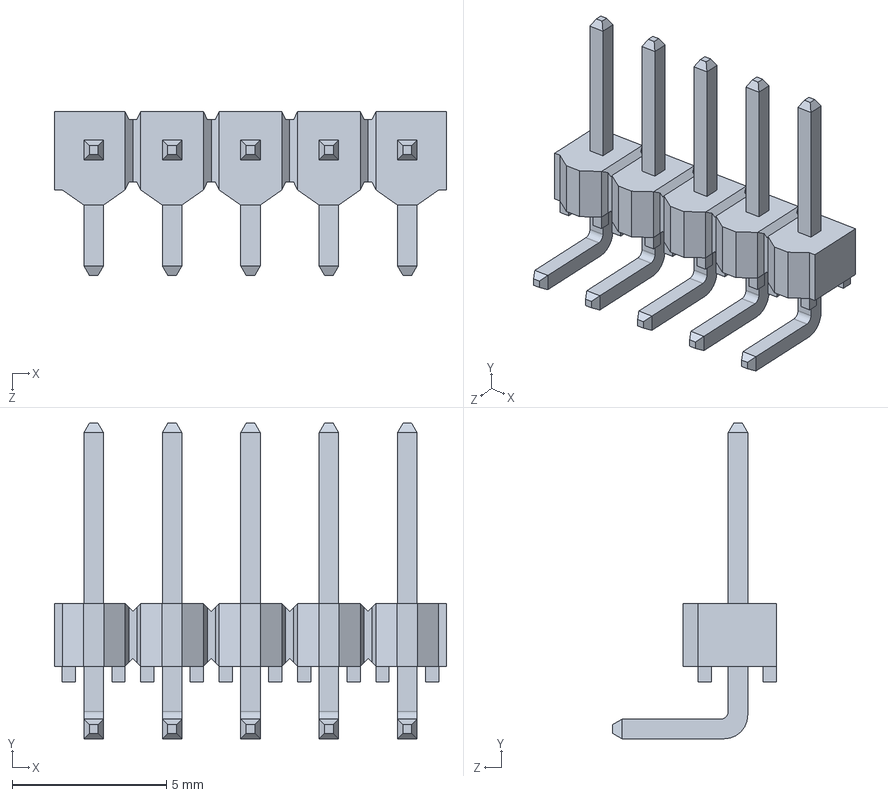
[picture p34: CAD file, 2025-10-29]
003 - Mécanique/3D/Dessins_3D_Modules-pièces/TSW-105-08-G-S-RA.SLDPRT
12.7 x 10.2 x 5.31 mm
