TechEdd/HapTGP-2025/003 - Mécanique/3D/Dessins_3D_Modules-pièces/2305 DRV2605L.step

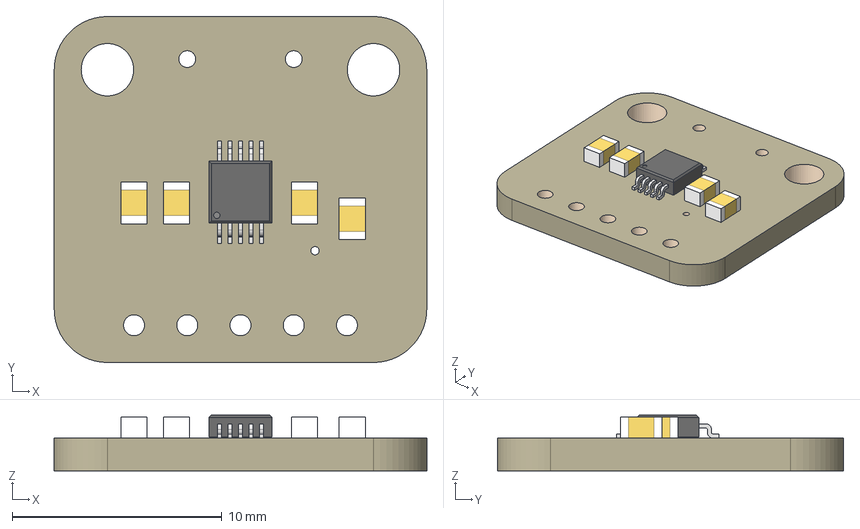
[picture p36: CAD file, 2025-10-29]
003 - Mécanique/3D/Dessins_3D_Modules-pièces/2305 DRV2605L.step
17.8 x 16.5 x 2.67 mm
Board
DRV2605LDGS
1uF x 4
