TechEdd/HapTGP-2025/003 - Mécanique/3D/Dessins_3D_Modules-pièces/Vis_M2_4mm_tête_ronde.SLDPRT

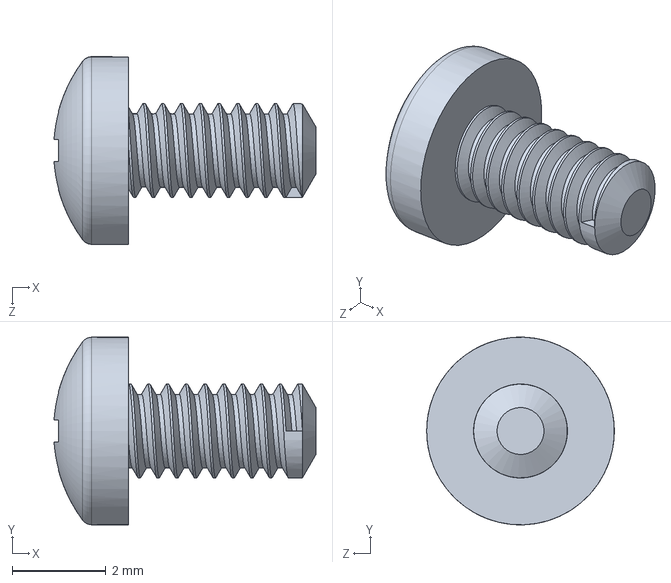
[picture p37: CAD file, 2025-10-29]
003 - Mécanique/3D/Dessins_3D_Modules-pièces/Vis_M2_4mm_tête_ronde.SLDPRT
5.58 x 4.00 x 4.00 mm
