TechEdd/HapTGP-2025/003 - Mécanique/3D/Dessins_3D_Modules-pièces/RBS-1_12.7mm_Rubber_Feet.SLDPRT

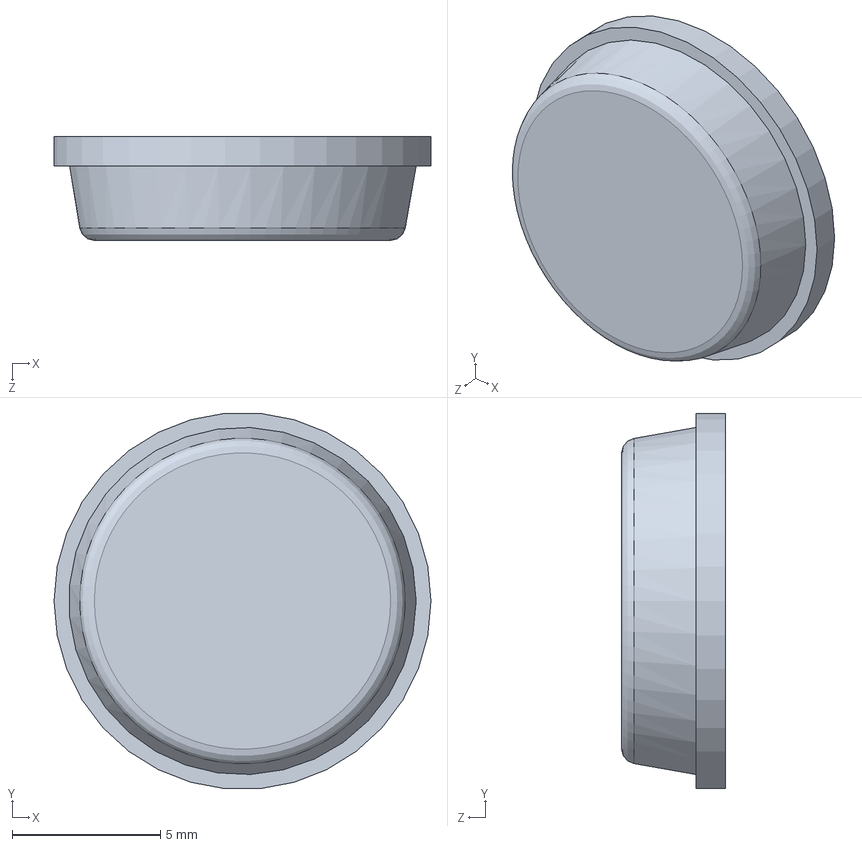
[picture p39: CAD file, 2025-10-29]
003 - Mécanique/3D/Dessins_3D_Modules-pièces/RBS-1_12.7mm_Rubber_Feet.SLDPRT
12.7 x 12.6 x 3.50 mm
