TechEdd/HapTGP-2025/003 - Mécanique/3D/Dessins_3D_Modules-pièces/Vis_M2.5_5mm_tête_ronde.SLDPRT

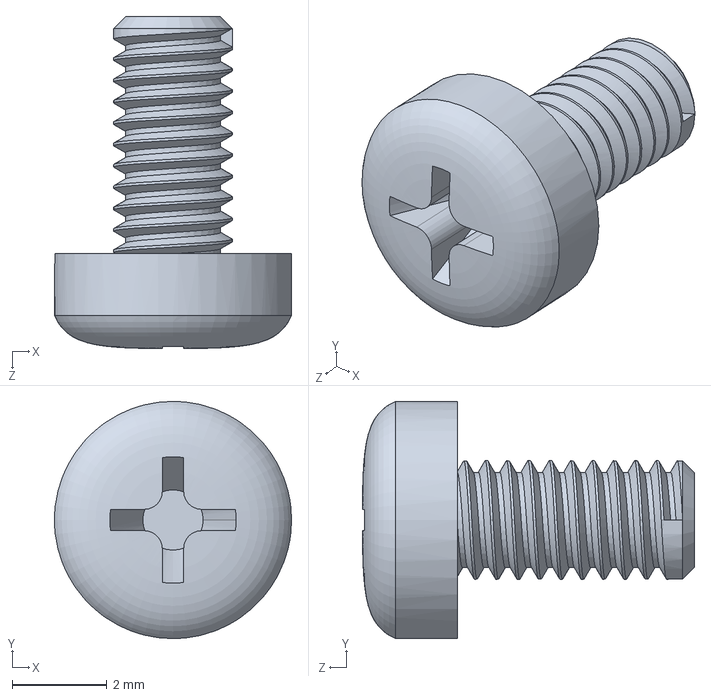
[picture p41: CAD file, 2025-10-29]
003 - Mécanique/3D/Dessins_3D_Modules-pièces/Vis_M2.5_5mm_tête_ronde.SLDPRT
5.00 x 5.00 x 7.00 mm
