TechEdd/HapTGP-2025/003 - Mécanique/3D/Dessins_3D_Modules-pièces/Module_VEML7700.SLDPRT

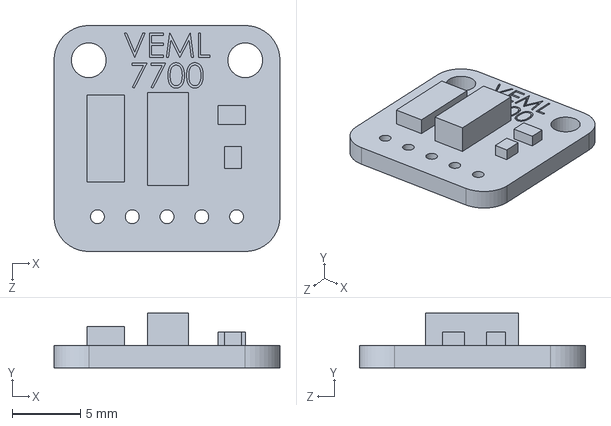
[picture p42: CAD file, 2025-10-29]
003 - Mécanique/3D/Dessins_3D_Modules-pièces/Module_VEML7700.SLDPRT
16.5 x 4.00 x 16.5 mm
