TechEdd/HapTGP-2025/003 - Mécanique/3D/Dessins_3D_Modules-pièces/CEM-1203_42.SLDPRT

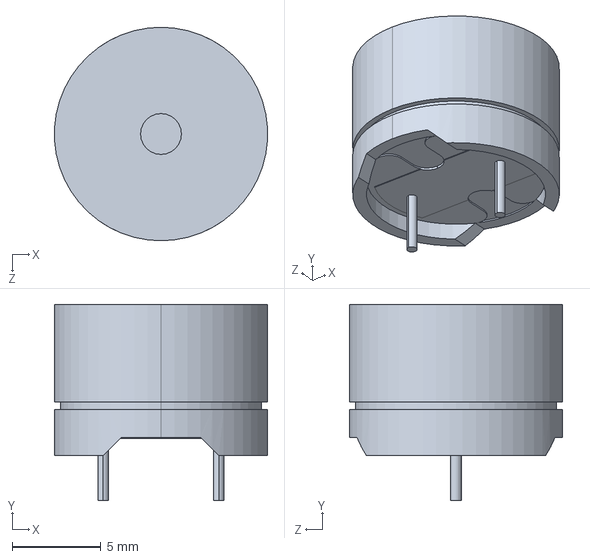
[picture p43: CAD file, 2025-10-29]
003 - Mécanique/3D/Dessins_3D_Modules-pièces/CEM-1203_42.SLDPRT
12.0 x 11.0 x 12.0 mm
