TechEdd/HapTGP-2025/003 - Mécanique/3D/Dessins_3D_Modules-pièces/Vis_M3_6mm_tête_ronde.SLDPRT

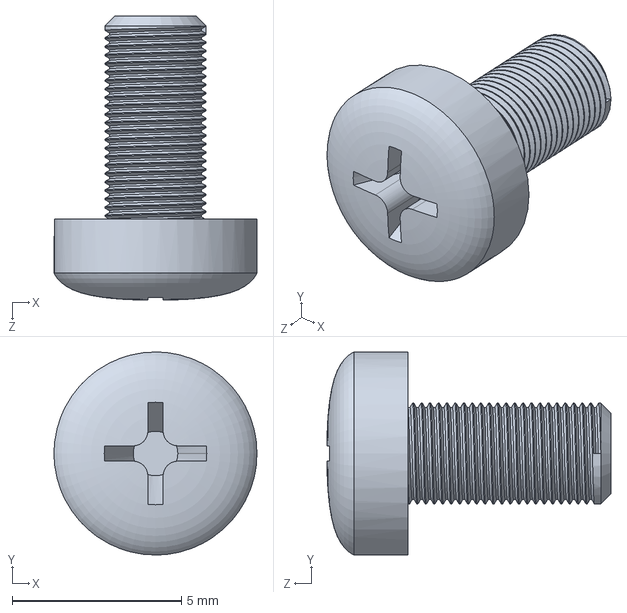
[picture p44: CAD file, 2025-10-29]
003 - Mécanique/3D/Dessins_3D_Modules-pièces/Vis_M3_6mm_tête_ronde.SLDPRT
6.00 x 6.00 x 8.39 mm
