TechEdd/HapTGP-2025/003 - Mécanique/3D/Dessins_3D_Modules-pièces/3D_hapTGP_w_silkscreen.SLDASM

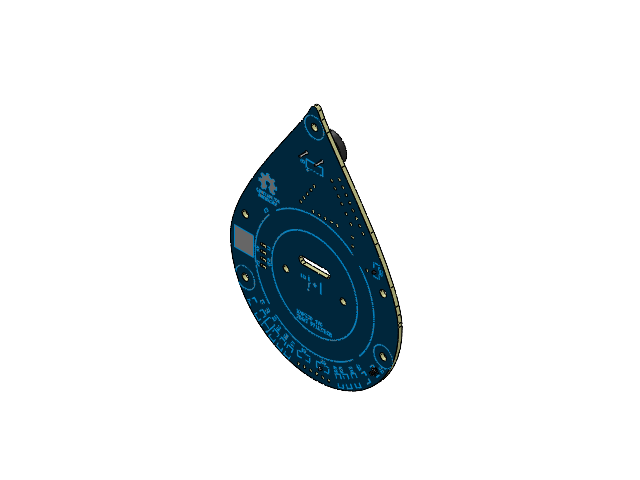
[picture p45: CAD file, 2025-11-11]
003 - Mécanique/3D/Dessins_3D_Modules-pièces/3D_hapTGP_w_silkscreen.SLDASM
Condensateur-C1206 x 2
Speaker
Diode-SOT
Board-PCB
TopSilkscreen~8vqI
BottomSilkscreen~8vqI
