TechEdd/HapTGP-2025/003 - Mécanique/3D/Dessins_3D_Modules-pièces/Assemblage_Raspberry_Zero_2.SLDASM

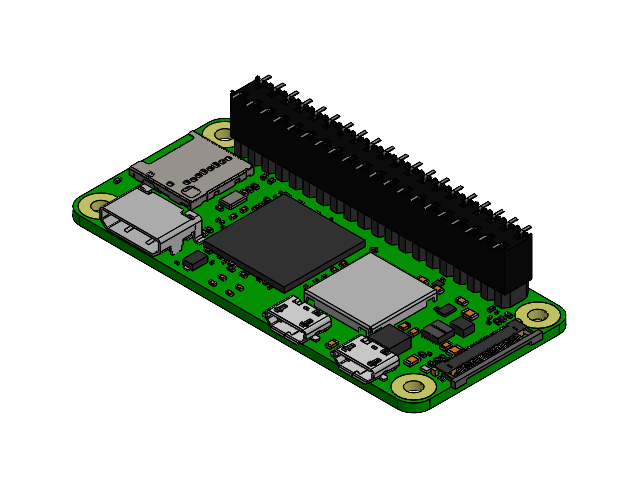
[picture p46: CAD file, 2025-11-11]
003 - Mécanique/3D/Dessins_3D_Modules-pièces/Assemblage_Raspberry_Zero_2.SLDASM
Raspberry Pi Zero 2 W with 40 pin male connector v4
SSM-120-L-DV
