TechEdd/HapTGP-2025/(list of files, cad)

Other CAD files:
003 - Mécanique/3D/Dessins_3D_Modules-pièces/Condensateur-C1206.SLDASM
003 - Mécanique/3D/Dessins_3D_Modules-pièces/Speaker.SLDASM
003 - Mécanique/3D/Dessins_3D_Modules-pièces/PCB-avec-Silskcreen.SLDASM
003 - Mécanique/3D/Dessins_3D_Modules-pièces/Diode-SOT.SLDASM
003 - Mécanique/3D/Dessins_3D_Modules-pièces/PCB Component_1.SLDASM
003 - Mécanique/3D/Dessins_3D_Modules-pièces/TopSilkscreen~8vqI.SLDPRT
003 - Mécanique/3D/Dessins_3D_Modules-pièces/BottomSilkscreen~8vqI.SLDPRT
003 - Mécanique/3D/Dessins_3D_Modules-pièces/Board-PCB.SLDPRT
003 - Mécanique/3D/Dessins_3D_Modules-pièces/VEML7700-IC.SLDPRT
003 - Mécanique/3D/Dessins_3D_Modules-pièces/Board_1.SLDPRT
003 - Mécanique/3D/Dessins_3D_Modules-pièces/DRV2605LDGS_1.SLDPRT
003 - Mécanique/3D/Dessins_3D_Modules-pièces/1uF_1.SLDPRT
003 - Mécanique/3D/Dessins_3D_Modules-pièces/Vis_M2_6mm_tête_ronde.SLDPRT
003 - Mécanique/3D/Dessins_3D_Modules-pièces/2305 DRV2605L.SLDASM
003 - Mécanique/3D/Dessins_3D_Modules-pièces/84592VEML7700.stp
003 - Mécanique/3D/Dessins_3D_Modules-pièces/CON1_1X1_TU_TSW_SAI.SLDPRT
003 - Mécanique/3D/Dessins_3D_Modules-pièces/Condensateur-C1206.SLDPRT
003 - Mécanique/3D/Dessins_3D_Modules-pièces/Diode-SOT.SLDPRT
003 - Mécanique/3D/Dessins_3D_Modules-pièces/M3 insert nut brass.SLDPRT
003 - Mécanique/3D/Dessins_3D_Modules-pièces/Speaker.SLDPRT
003 - Mécanique/3D/Dessins_3D_RPI/Support_RPI_Zero_2W.STL
