TechEdd/HapTGP-2025/003 - Mécanique/Schémas/SCH-MB_RPI_ZERO_2W_1V1.pdf

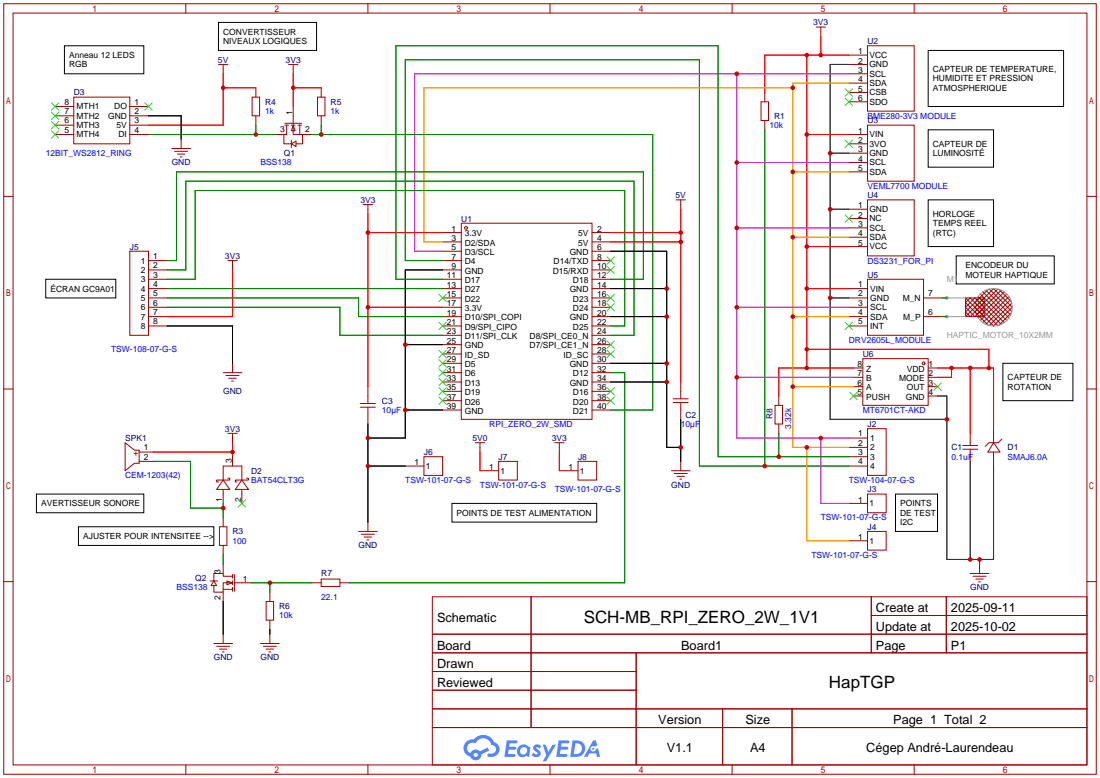
[picture p47: page 1]

POINTS DE TEST ALIMENTATION

Schematic | SCH-MB_RPI_ZERO_2W_1V1 | Create at | 2025-09-11

Update at | 2025-10-02

Board | Board1 | Page | P1
Drawn | | HapTGP
Reviewed

Version | Size | Page 1 Total 2
V1.1 | A4 | Cégep André-Laurendeau

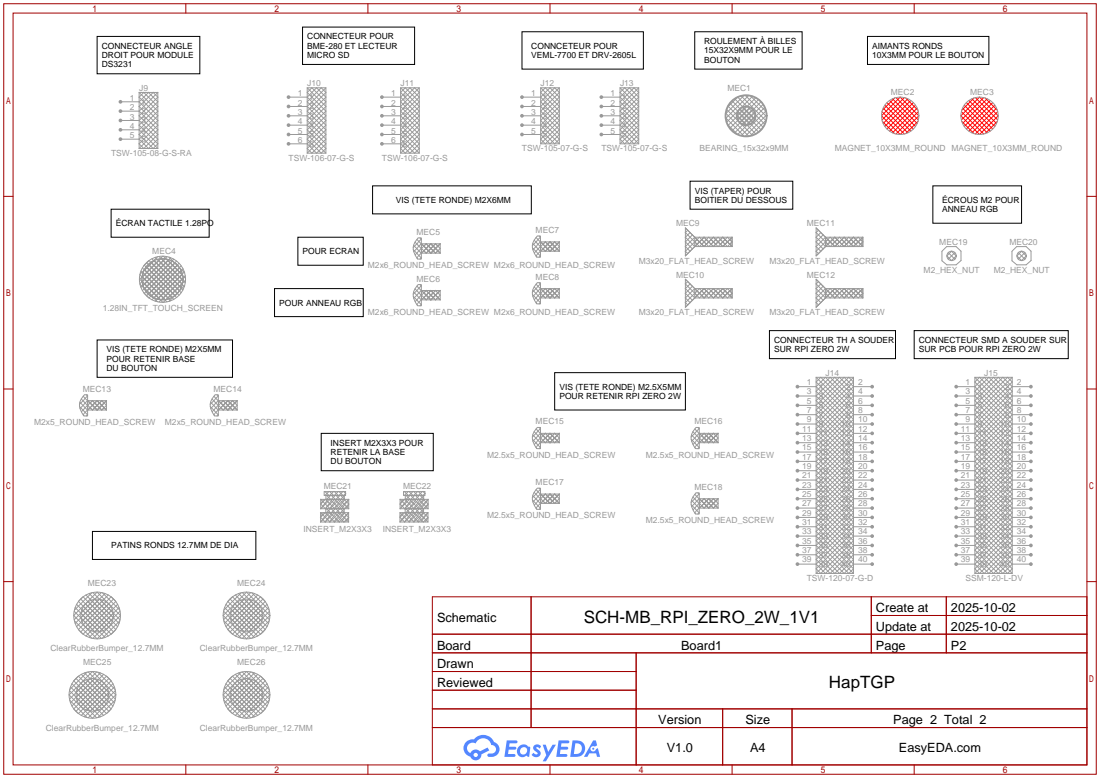
[picture p48: page 2]

CONNECTEUR SMD A SOUDER SUR
SUR PCB POUR RPI ZERO 2W

VIS (TETE RONDE) M2.5X5MM
POUR RETENIR RPI ZERO 2W

PATINS RONDS 12.7MM DE DIA

Schematic | SCH-MB_RPI_ZERO_2W_1V1 | Create at | 2025-10-02

Update at | 2025-10-02

Board | Board1 | Page | P2
Drawn | | HapTGP
Reviewed

Version | Size | Page 2 Total 2
V1.0 | A4 | EasyEDA.com
