TechEdd/HapTGP-2025/(list of files, drawings)

Other design files:
003 - Mécanique/Schémas/ProDoc_hapTGP_2025-10-23.epro
