TechEdd/HapTGP-2025/003 - Programmation/CODES EXEMPLES/ECRAN.py

#fonctionnel
#https://docs.circuitpython.org/projects/gc9a01a/en/latest/
import board
import displayio
import terminalio
from adafruit_display_text.bitmap_label import Label
from fourwire import FourWire

from adafruit_gc9a01a import GC9A01A

spi = board.SPI()
tft_cs = board.D8
tft_dc = board.D25
tft_reset = board.D27

displayio.release_displays()

display_bus = FourWire(spi, command=tft_dc, chip_select=tft_cs, reset=tft_reset)
display = GC9A01A(display_bus, width=240, height=240)

# Make the display context
main_group = displayio.Group()
display.root_group = main_group

bg_bitmap = displayio.Bitmap(240, 240, 2)
color_palette = displayio.Palette(2)
color_palette[0] = 0xEE00FF  # Bright Pink

bg_sprite = displayio.TileGrid(bg_bitmap, pixel_shader=color_palette, x=0, y=0)
main_group.append(bg_sprite)


# Draw a label
text_group = displayio.Group(scale=2, x=50, y=120)
text = "Hello World!"
text_area = Label(terminalio.FONT, text=text, color=0x000000)
text_group.append(text_area)  # Subgroup for text scaling
main_group.append(text_group)

while True:
    color_palette[0] = int(input(), 16)
    bg_sprite = displayio.TileGrid(bg_bitmap, pixel_shader=color_palette, x=0, y=0)
    main_group.append(bg_sprite)
