TechEdd/HapTGP-2025/(commit log)

2025-10-22 intial commit
    [Copie de Identification_Fils.xlsx, SCH-MB_RPI_ZERO_2W_ELEC_1V1.dxf, SCH-MB_RPI_ZERO_2W_MEC_1V1.dxf]
2025-10-29 Ajout des nouveaux fichiers 3D et BOM
    [004-BOM_TOTAL_1V0.xlsx, 1uF_1.SLDPRT, 2305 DRV2605L.SLDASM, 2305 DRV2605L.step, 3D_hapTGP.SLDASM, 3D_hapTGP_PCB_2025-10-23 (1).SLDASM, 3D_hapTGP_PCB_2025-10-23 (1).step, 3D_hapTGP_w_silkscreen(2).SLDASM]
2025-11-11 Rename et fichiers 3D pour assemblage
    [004-BOM_TOTAL_1V0.xlsx, 1uF_1.SLDPRT, 2305 DRV2605L.SLDASM, 2305 DRV2605L.step, 3D_hapTGP.SLDASM, 3D_hapTGP_PCB_2025-10-23 (1).SLDASM, 3D_hapTGP_PCB_2025-10-23 (1).step, 3D_hapTGP_w_silkscreen(2).SLDASM]
2025-12-02 Nouveau menu
    [Étalonnage VEML7700.xlsx]
